ultrazohm/uz_a_iepe/Project Outputs for uz_d_iepe/BOM/BOM_uz_d_iepe_1v01.xls

Quantity | Comment | Designator | MF | MPN | Value | Description | Footprint | Package | Voltage | Dielectric | Supplier 1 | Supplier Part Number 1 | Supplier 2 | Supplier Part Number 2 | Supplier 3 | Supplier Part Number 3
39 | 0.1 µF | C1, C5A, C5B, C5C, C5D, C19, C21, C26, C28, C31, C33, C35, C42, C43, C45, C49, C51, C54, C56, C58, C65, C66, C69, C70, C72A, C72B, C72C, C72D, C73A, C73B, C73C, C73D, C77, C86, C88, C92, C93, C95, C103 |  |  | 0.1 µF | Capacitor 0603, 50 VDC, 0.1 µF, X7R, Capacitor 0603, 25 VDC, 0.1 µF, X7R | C_0603 |  |  |  | Mouser | 80-C0603X104K5R7411, 80-C0603C104J3RE7411 | LCSC, [NoParam] | #NAME?, [NoParam]
8 | 750 pF | C2A, C2B, C2C, C2D, C3A, C3B, C3C, C3D |  |  | 750 pF | Capacitor 0603, 50 VDC, 750 pF, C0G | C_0603 |  |  |  | Mouser | 80-C0603C751J5GAUTO
8 | 10 µF | C4A, C4B, C4C, C4D, C11A, C11B, C11C, C11D |  |  | 10 µF | Capacitor 0805, 25 VDC, 10 µF, X5R | C_0805 |  |  |  | Mouser | 81-GRM219R61E106KA2D
16 | 1 µF | C6A, C6B, C6C, C6D, C7A, C7B, C7C, C7D, C12A, C12B, C12C, C12D, C38A, C38B, C38C, C38D |  |  | 1 µF | Capacitor 0603, 6.3 VDC, 1 µF, X7R, Capacitor 0603, 50 VDC, 1 µF, X7R | C_0603 |  |  |  | Mouser | 963-JMK107BJ105MA-T, 963-UMK107AB7105KA-T
8 | 18 nF | C8A, C8B, C8C, C8D, C10A, C10B, C10C, C10D |  |  | 18 nF | Capacitor 0603, 16 VDC, 18 nF, X7R | C_0603 |  |  |  | Mouser | 80-C0603C183K4R
4 | 12 nF | C9A, C9B, C9C, C9D |  |  | 12 nF | Capacitor 0603, 16 VDC, 12 nF, X7R | C_0603 |  |  |  | Mouser | 603-CC603KRX7R7BB123
16 | 470nF | C13A, C13B, C13C, C13D, C14A, C14B, C14C, C14D, C15A, C15B, C15C, C15D, C16A, C16B, C16C, C16D |  |  |  | Capacitor 0603, 25 VDC, 0.1 µF, X7R | C_0603
30 | 10 µF | C17, C20, C22, C24, C27, C29, C30, C36, C39, C41, C46, C47, C48, C52, C53, C57, C59, C63, C64, C67, C68, C71, C74, C80, C81, C85, C89, C90, C94, C96 |  |  | 10 µF | Capacitor 1206, 50 VDC, 10 µF, X7R, Capacitor 1206, 25 VDC, 10 µF, X7R, Capacitor 1206, 35 VDC, 10 µF, X5R | C_1206 |  |  |  | Mouser | 810-CGA5L1X7R1H106K1, 80-C1206C106J3RAUTO, 581-1206DD106MAT2A
20 | 0.01 µF | C18, C23, C25, C34, C40, C44, C50, C55, C60, C61, C78, C83A, C83B, C83C, C83D, C84A, C84B, C84C, C84D, C97 |  |  | 0.01 µF | Capacitor 0603, 50 VDC, 0.01 µF, X7R | C_0603 |  |  |  | Mouser | 81-GCJ188R71H103KA1D
8 | 75 pF | C32A, C32B, C32C, C32D, C37A, C37B, C37C, C37D |  |  | 75 pF | Capacitor 0603, 50 VDC, 75 pF, X7R | C_0603 |  |  |  | Mouser | 80-C0603C750J5RAUTO
2 | 7.5 nF | C62, C79 |  |  | 7.5 nF | Capacitor 0603, 25 VDC, 7.5 nF, C0G | C_0603 |  |  |  | Mouser | 80-C0603C752J3GACTU
2 | 47 µF | C75, C91 |  |  | 47 µF | Capacitor, 47µF, 35VDC Al Electrolyt | CAPAE830X650N |  |  |  | Mouser | 667-EEE-1VA470P | LCSC | #NAME?
2 | 0.027 µF | C76, C87 |  |  | 0.027 µF | Capacitor 0603, 50 VDC, 27 nF, X7R | C_0603 |  |  |  | Mouser | 581-06035C273J4T2A
4 | 100nF | C82A, C82B, C82C, C82D |  |  |  | Capacitor 0603, 25 VDC, 0.1 µF, X7R | C_0603
10 | #NAME? | D1, D2, D3, D4, D5, D6, D10, D11, D12, D13 |  |  |  | WL-SMCW SMD Mono-color Chip LED Waterclear Green, WL-SMCW SMD Mono-color Chip LED Waterclear Red, WL-SMCW SMD Mono-color Chip LED Waterclear Blue | WL-SMCW_0603 |  |  |  | Mouser | 710-150060GS84000, 710-150060RS86000, 710-150060BS84000 | Farnell | 3408612, 3408608, 3408611 | Digi-Key | 732-150060GS84000CT-ND, 732-150060RS86000CT-ND, 732-150060BS84000CT-ND
2 | #NAME? | D7, D8 |  |  | - | Schottky Rectifier, 1.5 A, 90 V | DIOM4227X23N |  |  |  | Mouser | 625-BYS12-90-E3/TR3
4 | #NAME? | D9A, D9B, D9C, D9D |  |  |  | Current Regulator Diodes 100V 3.5mA | CRD |  |  |  | Mouser | 954-S-352T
4 | #NAME? | J1A, J1B, J1C, J1D |  |  |  | BNC Connector | Right Angle BNC |  |  |  | Digi-Key | A97560-ND
8 | #NAME? | L1A, L1B, L1C, L1D, L7, L9, L16, L17 |  |  | 600 Ohm | Inductance, 0805, 100 MHz, 600 Ohm, 2 A | WE-CBF_0805_High Current |  |  |  | Mouser | 710-742792040
12 | 600 Ohm | L2, L3, L4, L5, L6, L8, L10, L11, L12, L13, L18, L19 |  |  | 600 Ohm | Inductance, 0805, 100 MHz, 600 Ohm, 2 A | WE-CBF_0805_High Current |  |  |  | Mouser | 710-742792040
2 | 150 µH | L14, L15 | EPCOS / TDK | B82464G4154M | 150 µH | Inductor SMT, 10 x 10, 150 µH, 0.8 A | SMT_inductor_1050 |  |  |  | Mouser | 871-B82464G4154M
10 | 100R | R1, R2, R69A, R69B, R69C, R69D, R70A, R70B, R70C, R70D |  |  | 100R | SMD resistor E24 series | RES 0603_1608 |  |  |  | Mouser | 660-RK73B1JTTD101J
18 | 0R | R3, R4, R5, R6, R14A, R14B, R14C, R14D, R31, R32, R40A, R40B, R40C, R40D, R51A, R51B, R51C, R51D |  |  | 0R | SMD resistor E24 series | RES 0603_1608 |  |  |  | Mouser | 603-RC0603JR-070RL | LCSC | #NAME?
4 | 4.99R | R7, R8, R9, R10 |  |  | 4.99R | SMD resistor 1% | RES 0603_1608 |  |  |  | Mouser | 71-CRCW0603-4.99-E3
4 | 16k2 | R11A, R11B, R11C, R11D |  |  | 16k2 | SMD resistor 1% | RES 0603_1608 |  |  |  | Mouser | 603-AC0603FR-0716K2L
8 | 24R9 | R12A, R12B, R12C, R12D, R13A, R13B, R13C, R13D |  |  | 24R9 | SMD resistor 1% | RES 0603_1608 |  |  |  | Mouser | 603-RC0603FR-1324R9L
4 | 82k | R15A, R15B, R15C, R15D |  |  | 82k | SMD resistor E24 series | RES 0603_1608 |  |  |  | Mouser | 660-RK73B1JTTDD823J
4 | 39k | R16A, R16B, R16C, R16D |  |  | 39k | SMD resistor E24 series | RES 0603_1608 |  |  |  | Mouser | 660-RK73B1JTTDD393J
4 | 22k | R17A, R17B, R17C, R17D |  |  | 22k | SMD resistor E24 series | RES 0603_1608 |  |  |  | Mouser | 660-RK73B1JTTD223J
8 | 22R | R18A, R18B, R18C, R18D, R19A, R19B, R19C, R19D |  |  |  | SMD resistor E24 series | RES 0603_1608
2 | 162k | R20, R42 |  |  | 162k | SMD resistor 1% | RES 0603_1608 |  |  |  | Mouser | 652-CR0603-FX1623ELF
2 | 75k | R21, R43 |  |  | 75k | SMD resistor E24 series | RES 0603_1608 |  |  |  | Mouser | 660-RK73B1JTTD753J
32 | 10k | R22A, R22B, R22C, R22D, R24A, R24B, R24C, R24D, R38, R39, R50, R52A, R52B, R52C, R52D, R53, R54, R55A, R55B, R55C, R55D, R56, R57A, R57B, R57C, R57D, R58A, R58B, R58C, R58D, R61, R62 |  |  | 10k | SMD resistor E24 series, SMD resistor 1% | RES 0603_1608 |  |  |  | Mouser, Farnell | 660-RK73B1JTTD103J, 2447230
4 | 10R | R23A, R23B, R23C, R23D |  |  |  | SMD resistor E24 series | RES 0603_1608
2 | 1k62 | R25, R44 |  |  | 1k62 | SMD resistor 1% | RES 0603_1608 |  |  |  | Mouser | 667-ERJ-P03F1621V
2 | 133k | R26, R45 |  |  | 133k | SMD resistor 1% | RES 0603_1608 |  |  |  | Mouser | 652-CR0603FX-1333ELF
3 | 6k2 | R27, R28, R65 |  |  | 6k2 | SMD resistor E24 series | RES 0603_1608 |  |  |  | Mouser | 660-RK73B1JTTD622J
5 | 510R | R29, R30, R36, R37, R59 |  |  | 510R | SMD resistor E24 series | RES 0603_1608 |  |  |  | Mouser | 660-RK73B1JTTD511J
4 | 1k2 | R33A, R33B, R33C, R33D |  |  | 1k2 | SMD resistor E24 series | RES 0603_1608 |  |  |  | Mouser | 660-RK73B1JTTD122J
4 | 5k36 | R34A, R34B, R34C, R34D |  |  | 5k36 | SMD resistor 1% | RES 0603_1608 |  |  |  | Mouser | 603-AC0603FR-075K36L
4 | 174k | R35A, R35B, R35C, R35D |  |  | 174k | SMD resistor 1% | RES 0603_1608 |  |  |  | Mouser | 603-RC0603FR-07174KL
2 | 1k02 | R41, R46 |  |  | 1k02 | SMD resistor 1% | RES 0603_1608 |  |  |  | Mouser | 652-CR0603FX-1021ELF
2 | 93k1 | R47, R49 |  |  | 93k1 | SMD resistor 1% | RES 0603_1608 |  |  |  | Mouser | 667-ERJ-P03F9312V
1 | 10k2 | R48 |  |  | 10k2 | SMD resistor 1% | RES 0603_1608 |  |  |  | Mouser | 667-ERJ-3EKF1022V
1 | 32k4 | R60 |  |  | 32k4 | SMD resistor 1% | RES 0603_1608 |  |  |  | Mouser | 667-ERJ-3EKF3242V
1 | 27k | R63 |  |  | 27k | SMD resistor E24 series | RES 0603_1608 |  |  |  | Mouser | 660-RK73B1JTTD273J
1 | 1k | R66 |  |  | 1k | SMD resistor E24 series | RES 0603_1608 |  |  |  | Mouser | 660-RK73B1JTTDD102J
5 | #NAME? | SW1, SW2A, SW2B, SW2C, SW2D |  |  |  | 04p, 1.27mm Pitch, Horizontal, HP Type, SMT, flat Actuator, black, with Tape, T&R | 416131160804 |  |  |  | LCSC | C319050
27 | #NAME? | TP1, TP2, TP3, TP4, TP5, TP6, TP7, TP8, TP9, TP13A, TP13B, TP13C, TP13D, TP14A, TP14B, TP14C, TP14D, TP16, TP17, TP21, TP22, TP25, TP27, TP30, TP31, TP32, TP33 |  |  | TP | Test Point 1 mm | TP_1mm |  |  |  | - | -
1 | #NAME? | U1 |  |  | 1:04:00 | High Performance Clock Puffer, 1:4 LVCMOS Fan-out | FP-PW0008A-MFG |  |  |  | Mouser | 595-CDCLVC1104PWR
3 | #NAME? | U2, U3, U15 | Texas Instruments | TPS7A3001DGN | -1.18 V - -33 V | -35 V, -200 mA, ultralow-noise, negative linear regulator | DGN0008D_N |  |  |  | Mouser | 595-TPS7A3001DGNR | Mouser | 595-TPS7A3001DGNT |  | 3122632
3 | #NAME? | U3, U5, U7 | Texas Instruments | LP2985A-25 | 5 V, 3.3 V, 2.5 V | 150 mA Low-noise Low-dropout regulator with shutdown; fixed 5 V output, 150 mA Low-noise Low-dropout regulator with shutdown; fixed 3.3 V output, 150 mA Low-noise Low-dropout regulator with shutdown; fixed 2.5 V output | SOT95P250X110-5N | SOT-23-5 |  |  | Mouser | 595-LP2985A-50DBVT, 595-LP2985A-33DBVT, 595-LP2985A-25DBVT
4 | #NAME? | U4A, U4B, U4C, U4D |  |  | Differential ADC | Differential Input ADC with Wide Input Common Mode Range | TSSOP50P510X110_HS-17N |  |  |  | Mouser | 584-C2311CMSE-16PBF
1 | #NAME? | U8 |  |  |  | Low-Voltage 16-Bit I2C and SMBus Low-Power I/O Expander | SOP65P640X120-24N |  |  |  | Mouser | 595-TCA9535PWR
2 | #NAME? | U9, U11 |  |  | 500 mA | Buck Converter with 80 V integrated Power MOSFET, U_in 9 V - 75 V, U_out 2.5 V - 73 V, I_out 500 mA | TSOP65P490X110-8N |  |  |  | Mouser | 926-LM5007MM/NOPB
1 | #NAME? | U10 |  |  |  | 150 mA Low-noise Low-dropout regulator with shutdown | SOT95P250X110-5N | SOT-23-5 |  |  | Mouser | 595-LP2985A-18DBVJ
1 | #NAME? | U12 |  |  | 5 V | Precision Wide Supply High Output Drive Low Noise Reference, 5 V | SOT95P280X100-6N |  |  |  | Mouser | 584-6654AIS65TRMPBF
4 | #NAME? | U13A, U13B, U13C, U13D |  |  |  | Precision,Zero-Drift,High-Voltage,Programmable Gain Instrumentation Amplifier | PW0016A_N |  |  |  | Mouser | 595-PGA281AIPW
4 | #NAME? | U14A, U14B, U14C, U14D |  |  | Rail-to-Rail | Operational Amplifier, Rail-to-Rail, ultralow noise | MSOP8_3x3-8N |  |  |  | Mouser | 584-LT6203CMS8#PBF
