ultrazohm/uz_a_iepe/Project Outputs for uz_d_iepe/SCH_uz_d_iepe_1v01.PDF

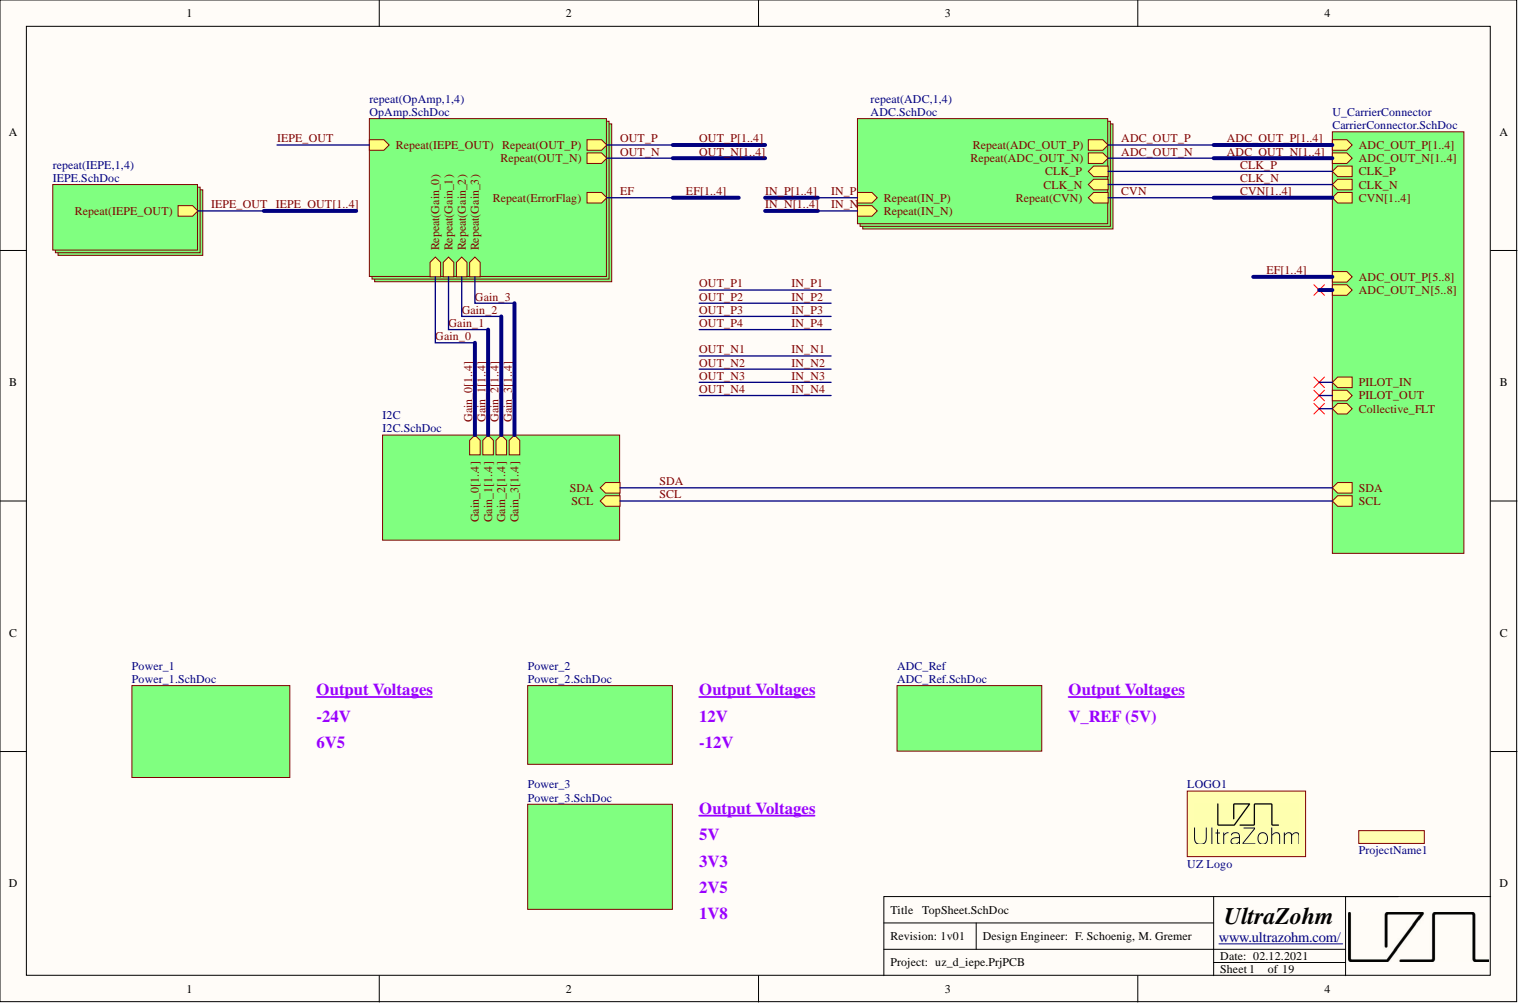
[picture p1: page 1]

Title TopSheet.SchDoc | www.ultrazohm.com/

Revision:
Project: uz_d_iepe.PrjPCB | Date: 02.12.2021

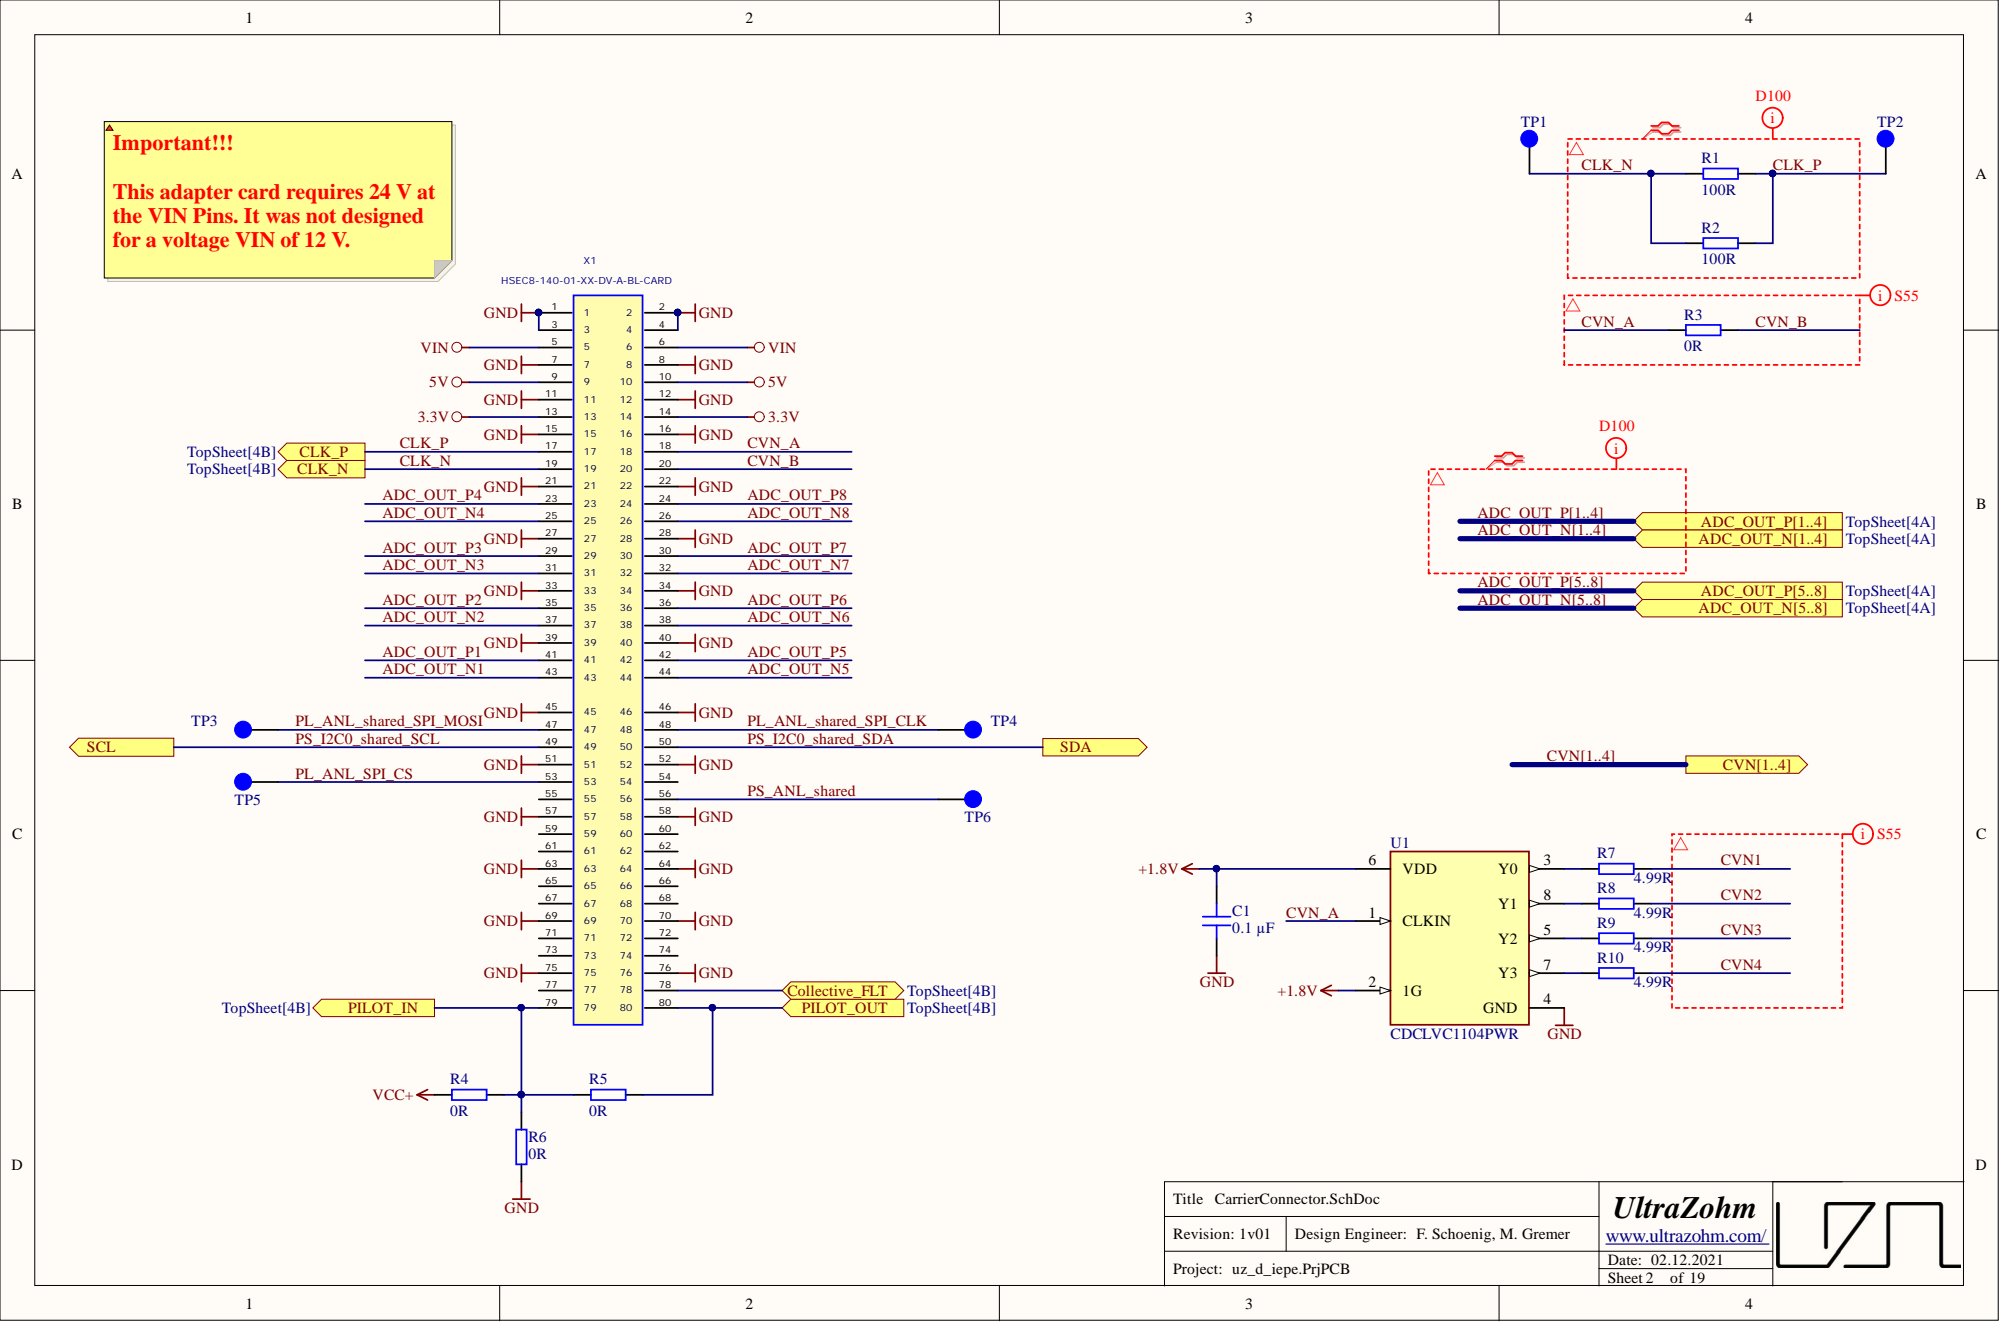
[picture p2: page 2]

This adapter card requires 24 V at
the VIN Pins. It was not designed
for a voltage VIN of 12 V.

HSEC8-140-01-XX-DV-A-BL-CARD

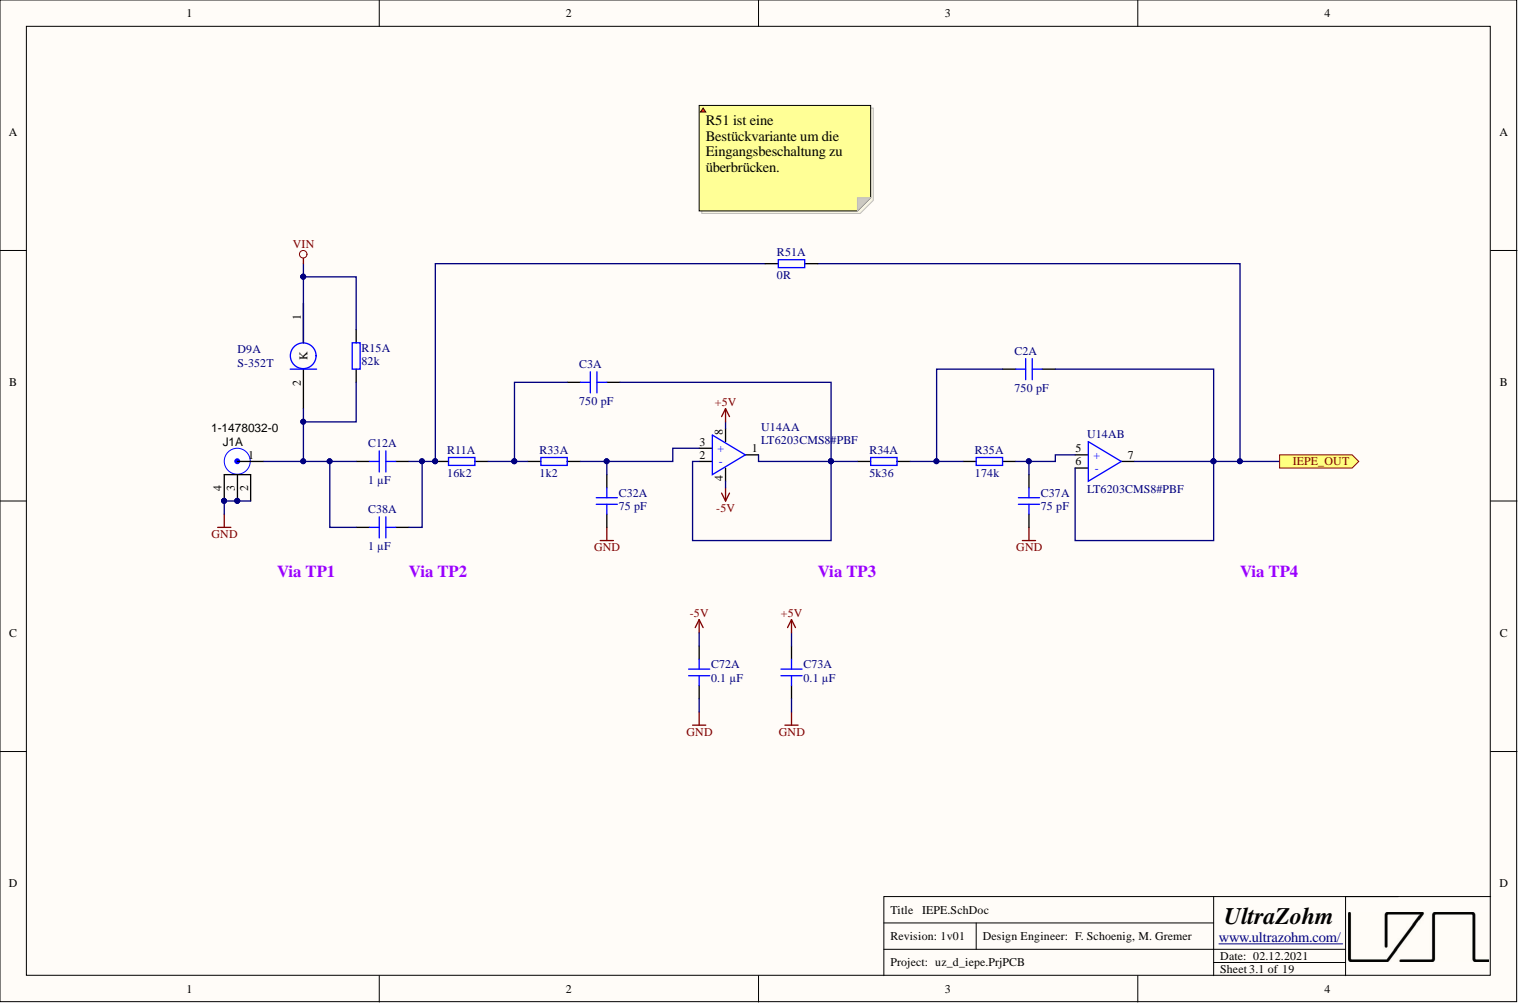
[picture p3: page 3]

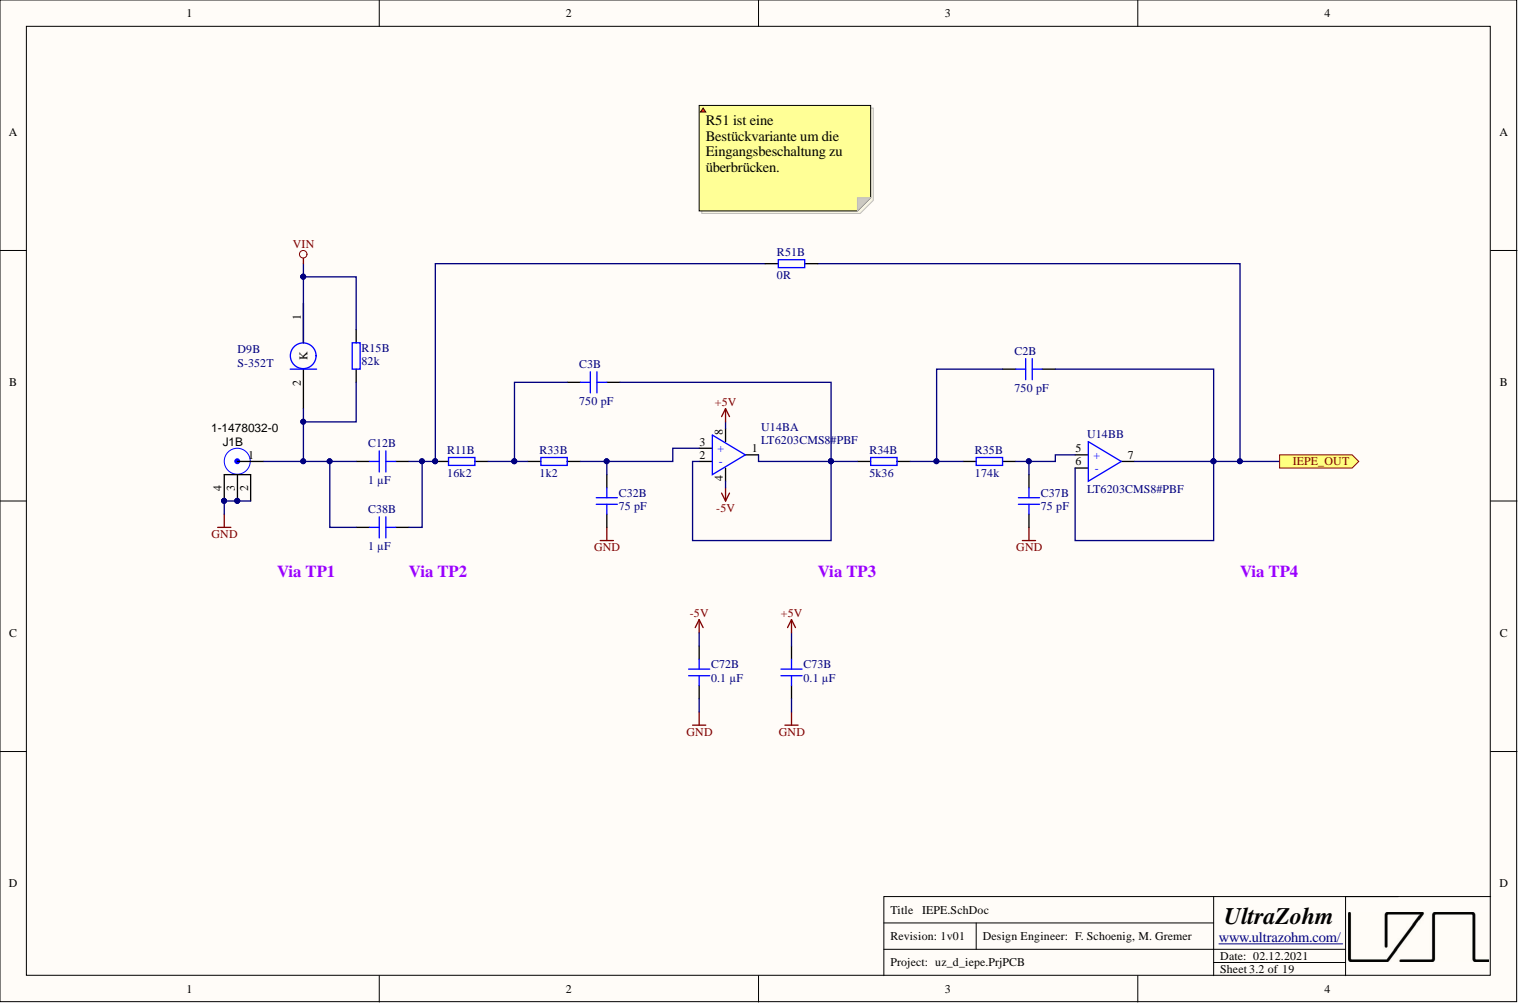
[picture p4: page 4]

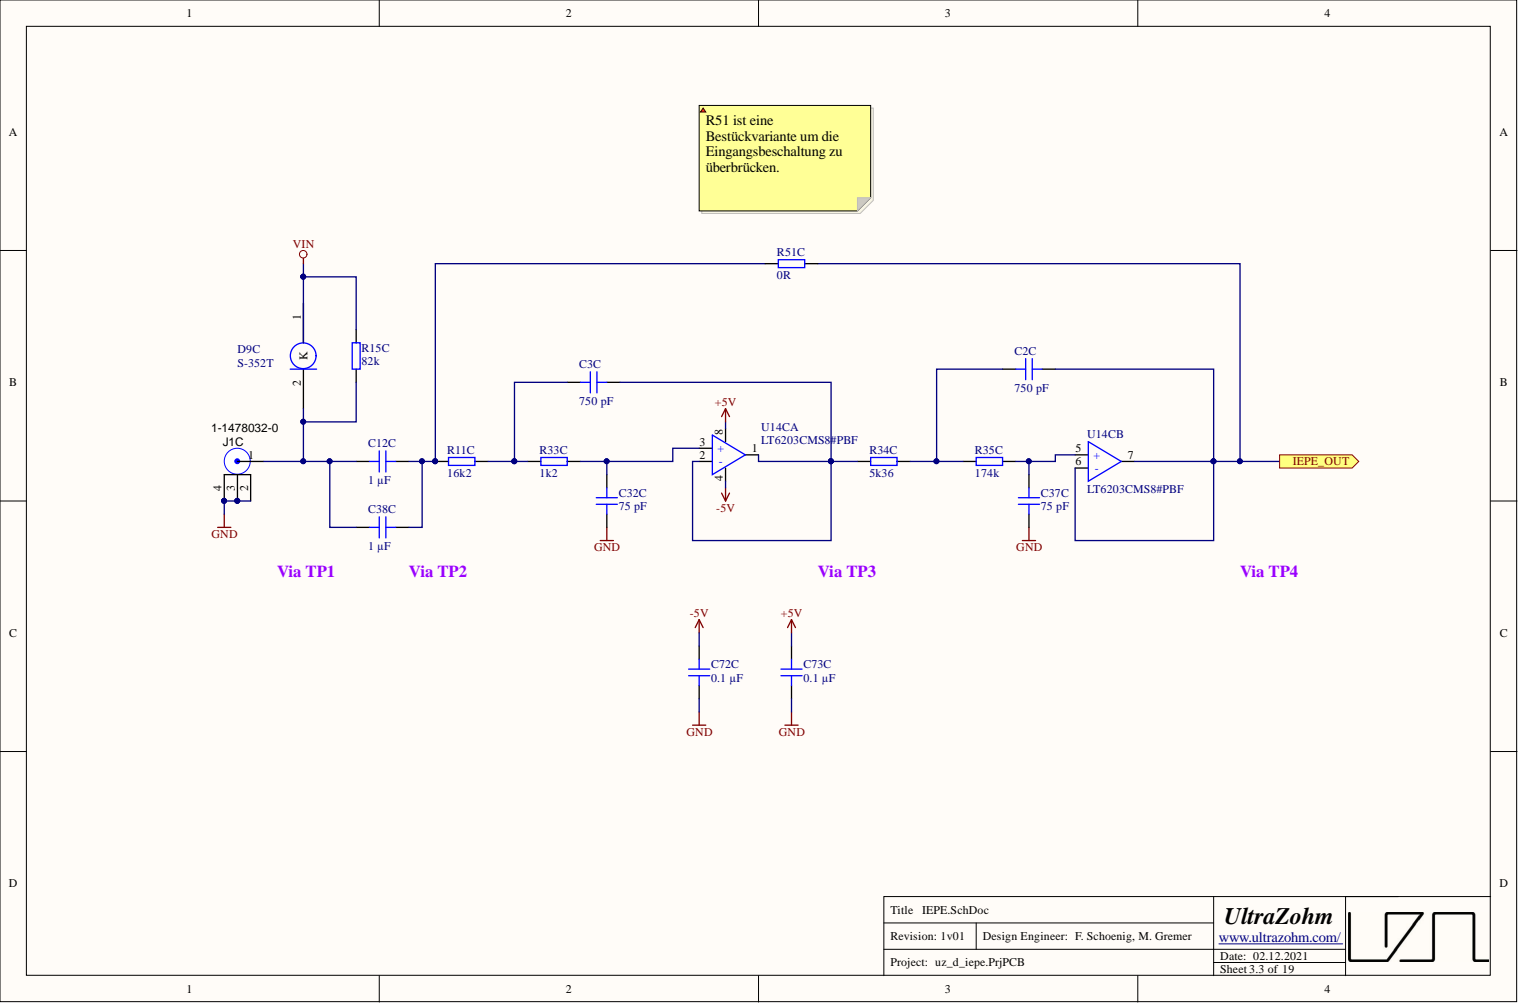
[picture p5: page 5]

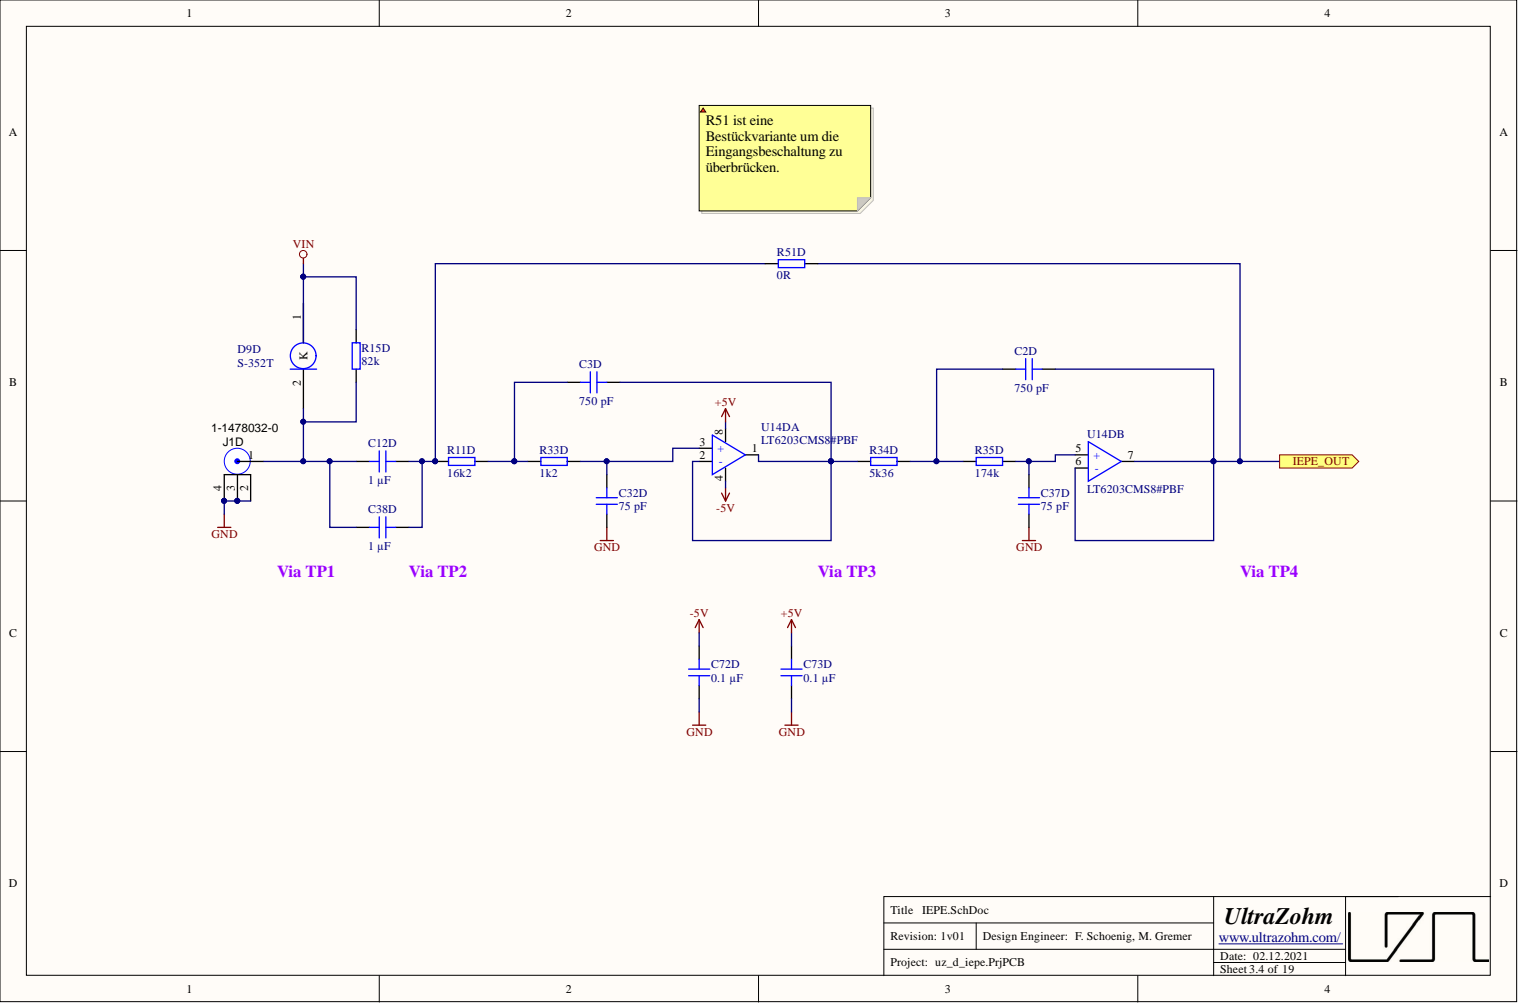
[picture p6: page 6]

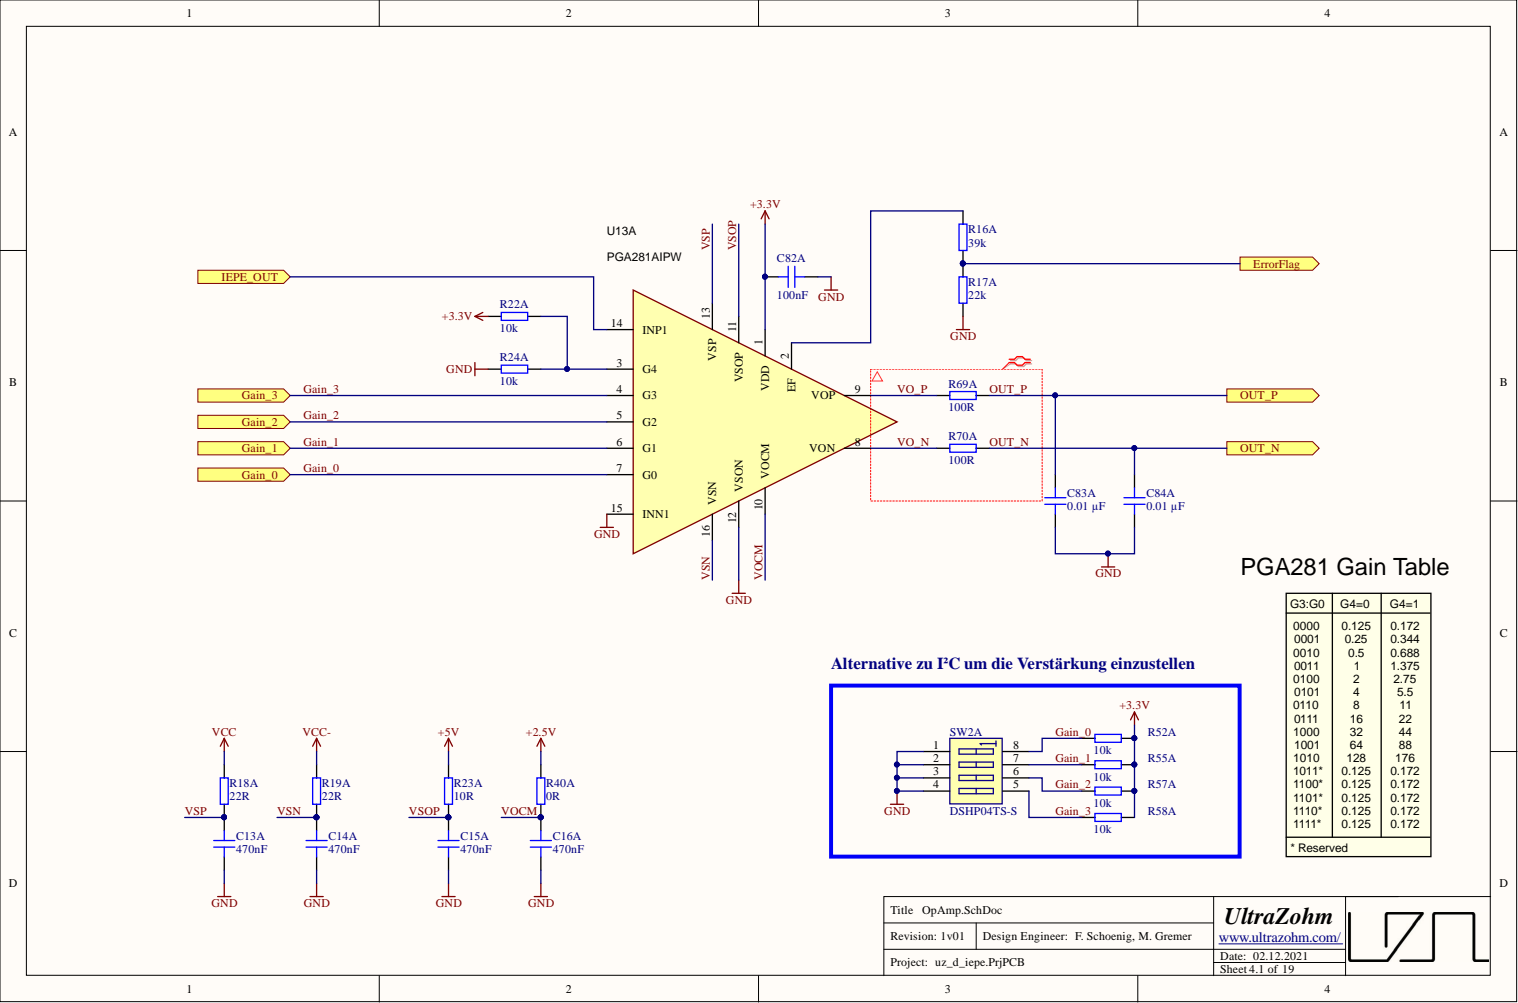
[picture p7: page 7]

Alternative zu I²C um die Verstärkung einzustellen

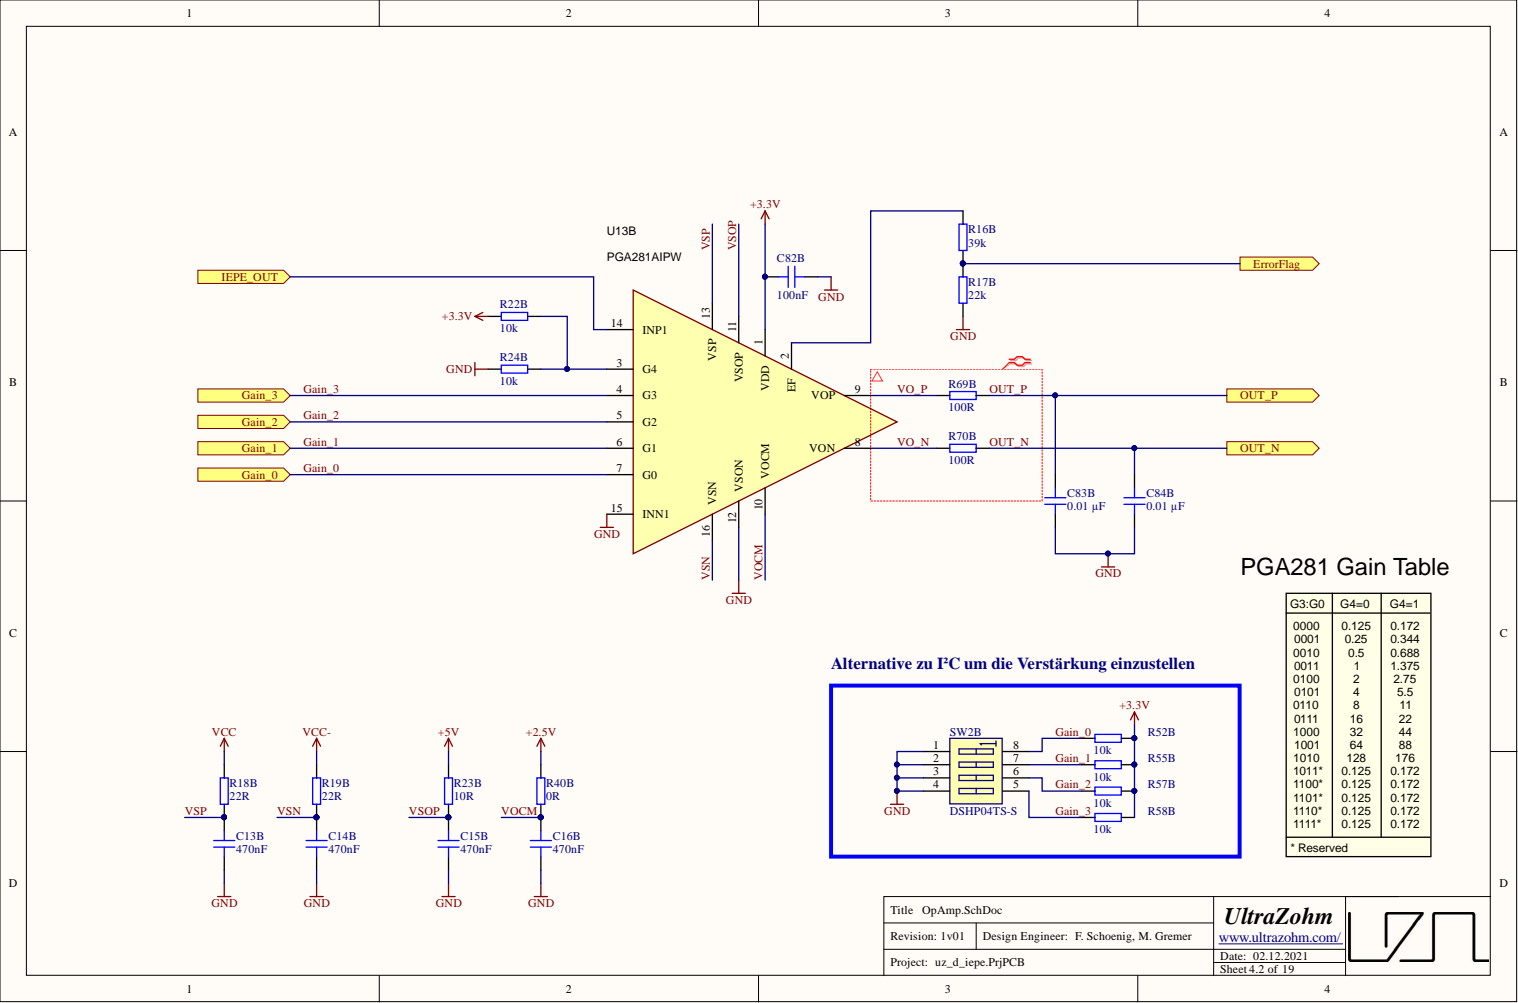
[picture p8: page 8]

Alternative zu I²C um die Verstärkung einzustellen

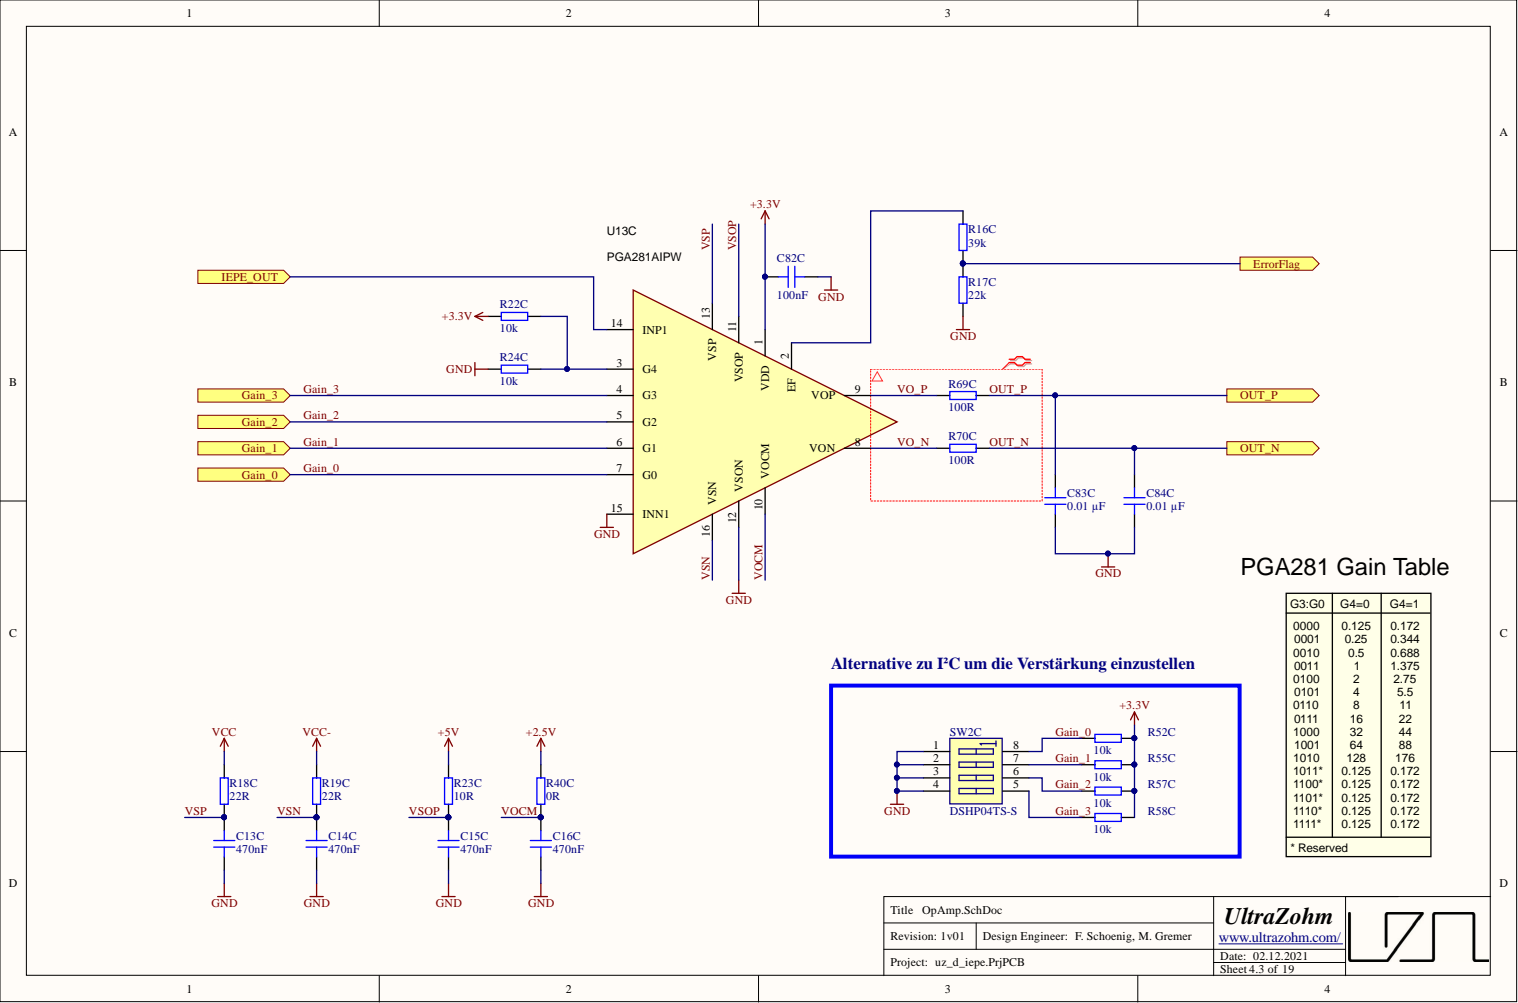
[picture p9: page 9]

Alternative zu I²C um die Verstärkung einzustellen

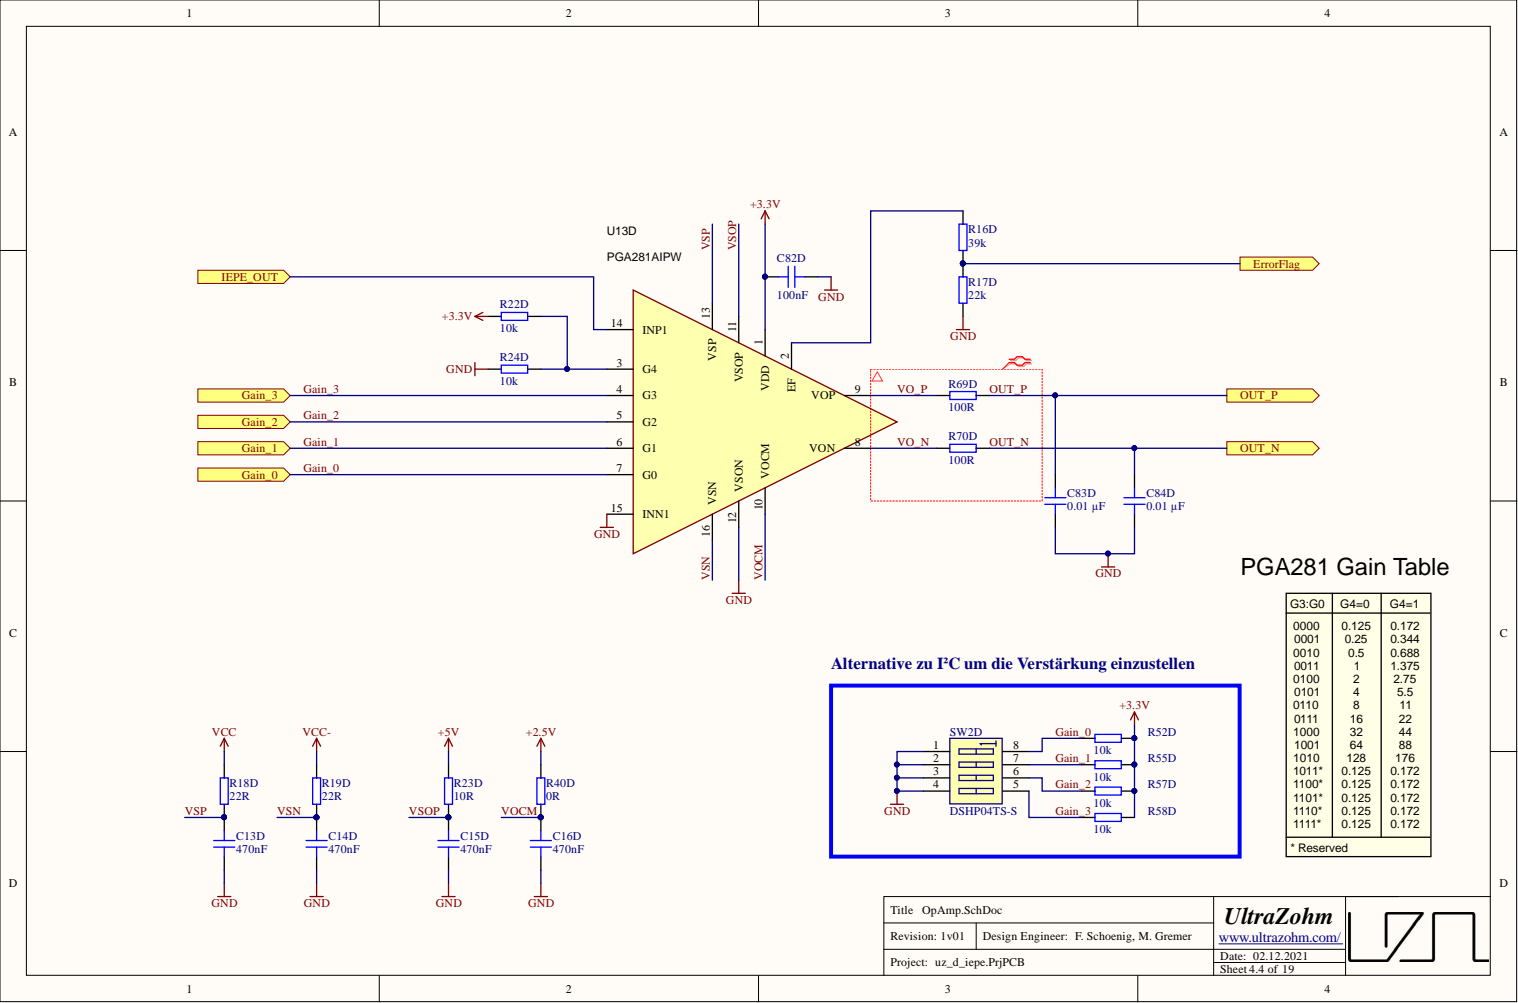
[picture p10: page 10]

Alternative zu I²C um die Verstärkung einzustellen

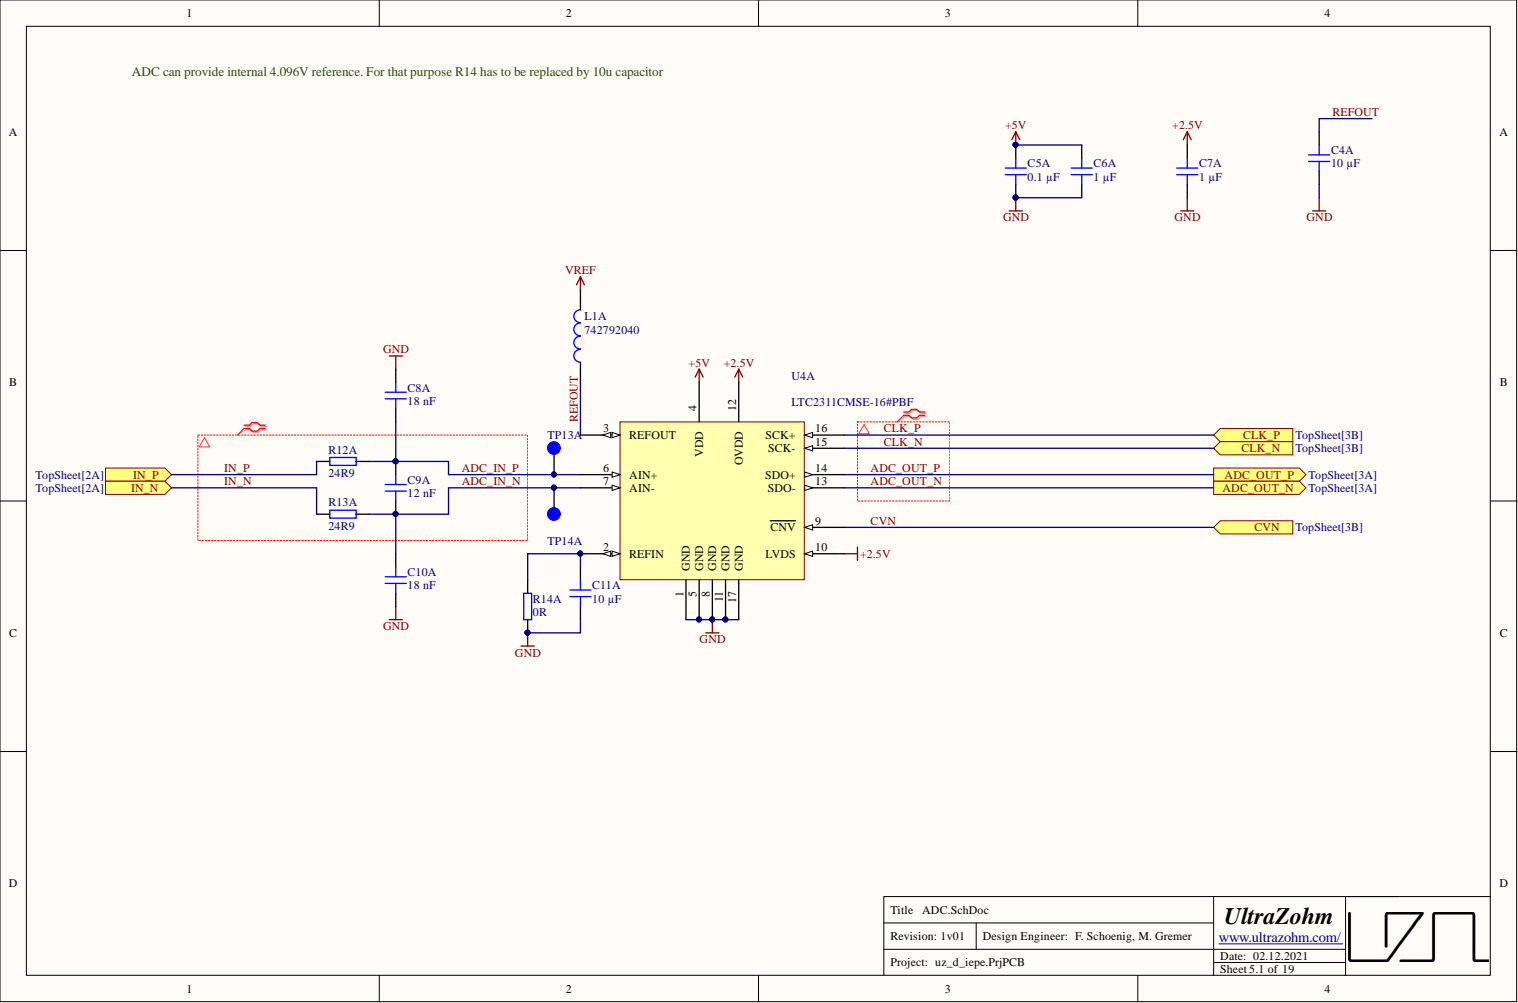
[picture p11: page 11]

IN _ P
IN _ N | A DC_IN _ N | 7 | 1 | A DC_ O U T _ N

14 3 SDO+ | A DC_ O U T _ P

T i t l e A DC.Sch D o c | UltraZohm w w.ultra z o h m.c m/

Rev i s n : v | Des g n E neer: F. Sch oen g, M. Gremer

Project uz_ d _ iepe.PrjPCB

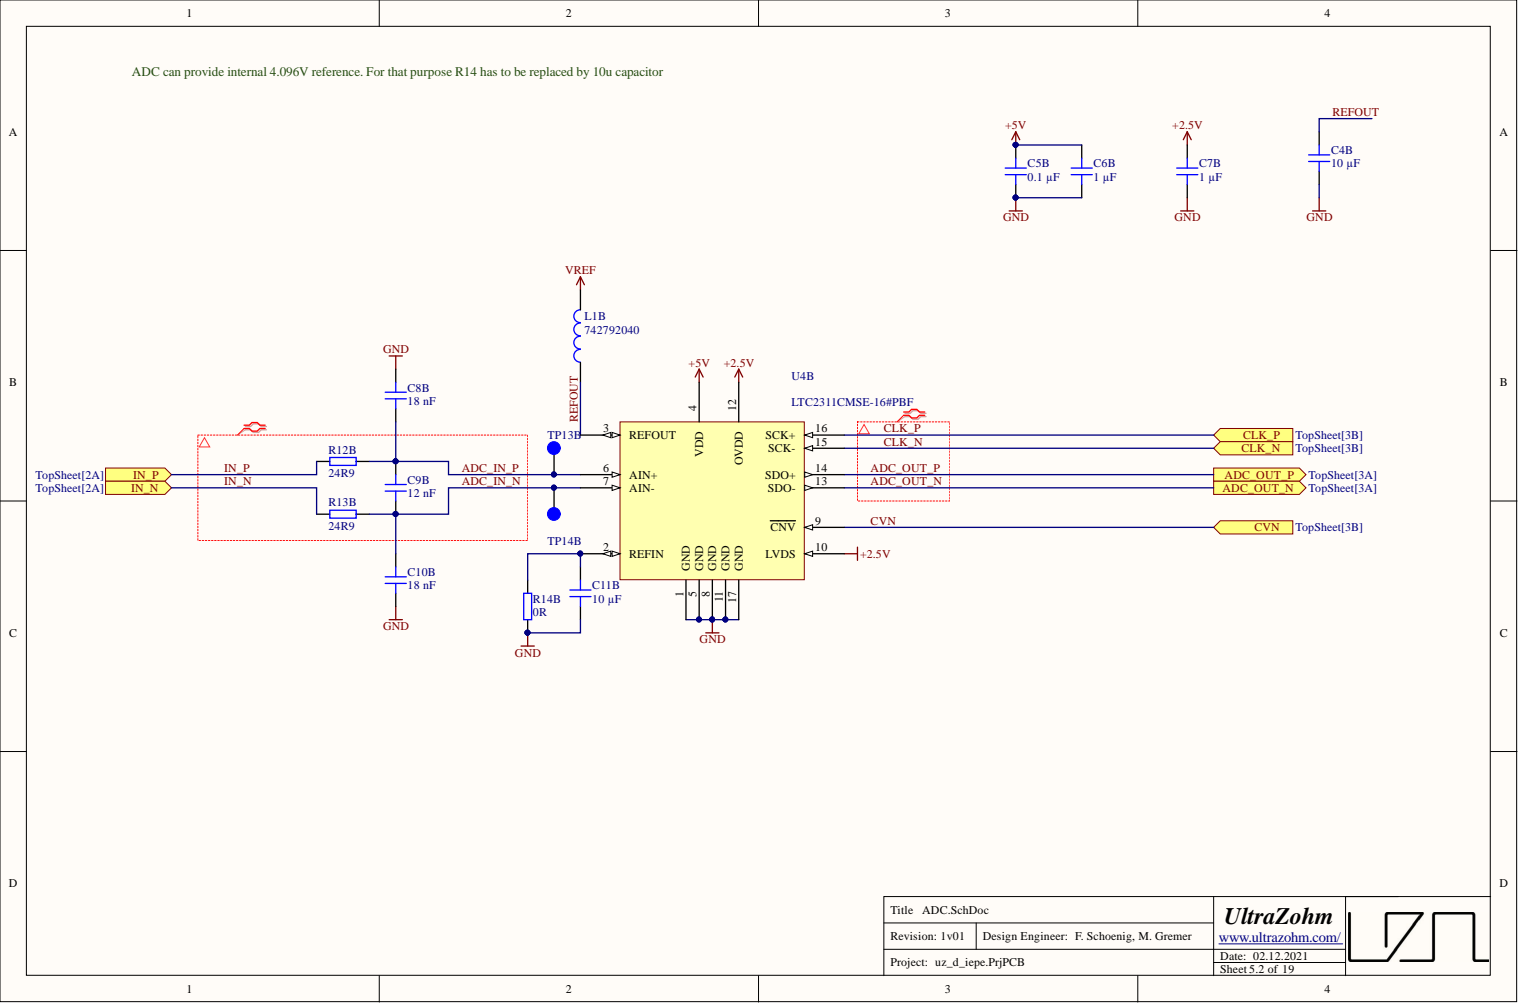
[picture p12: page 12]
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

14 3 SDO+ | A DC_ O U T _ P

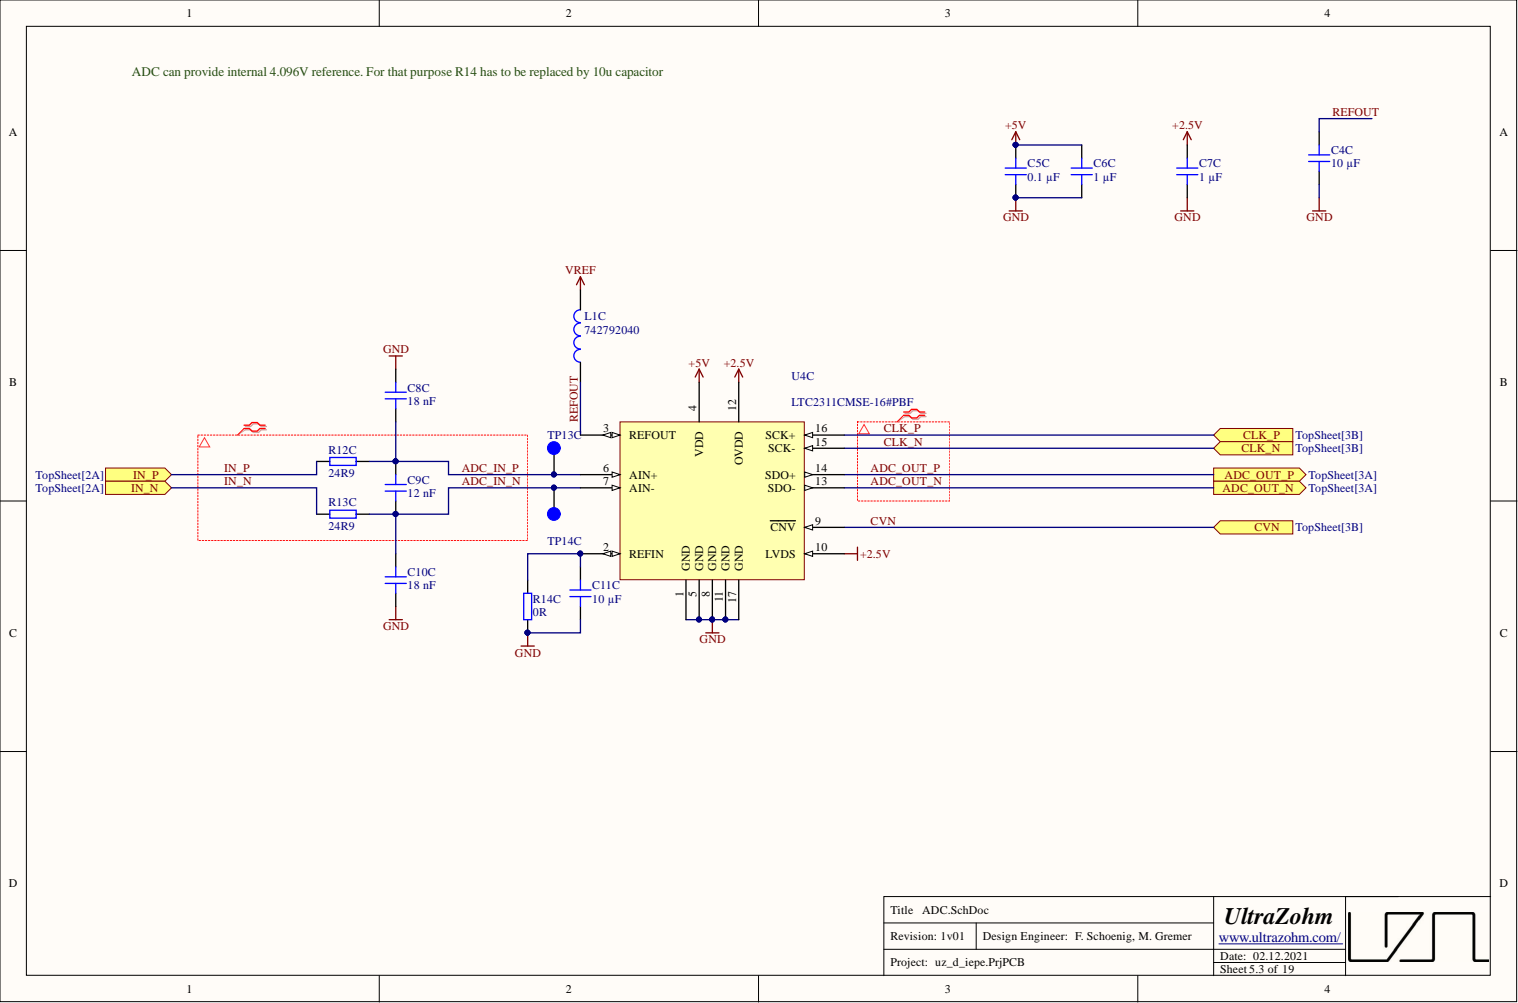
[picture p13: page 13]
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

14 3 SDO+ | A DC_ O U T _ P

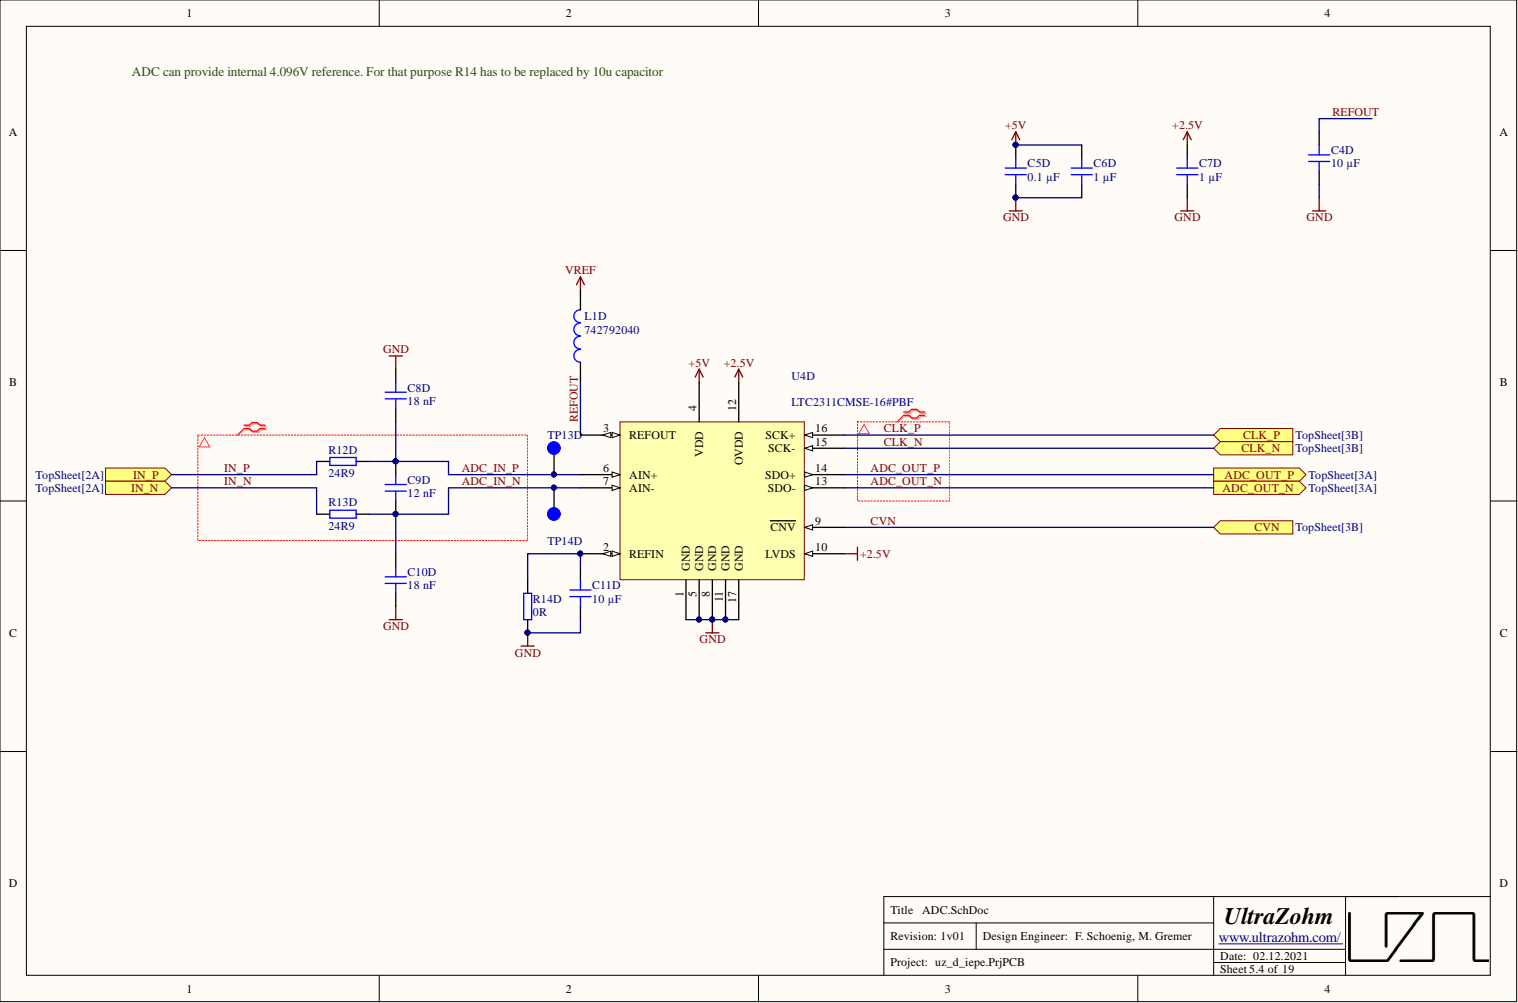
[picture p14: page 14]
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

14 3 SDO+ | A DC_ O U T _ P

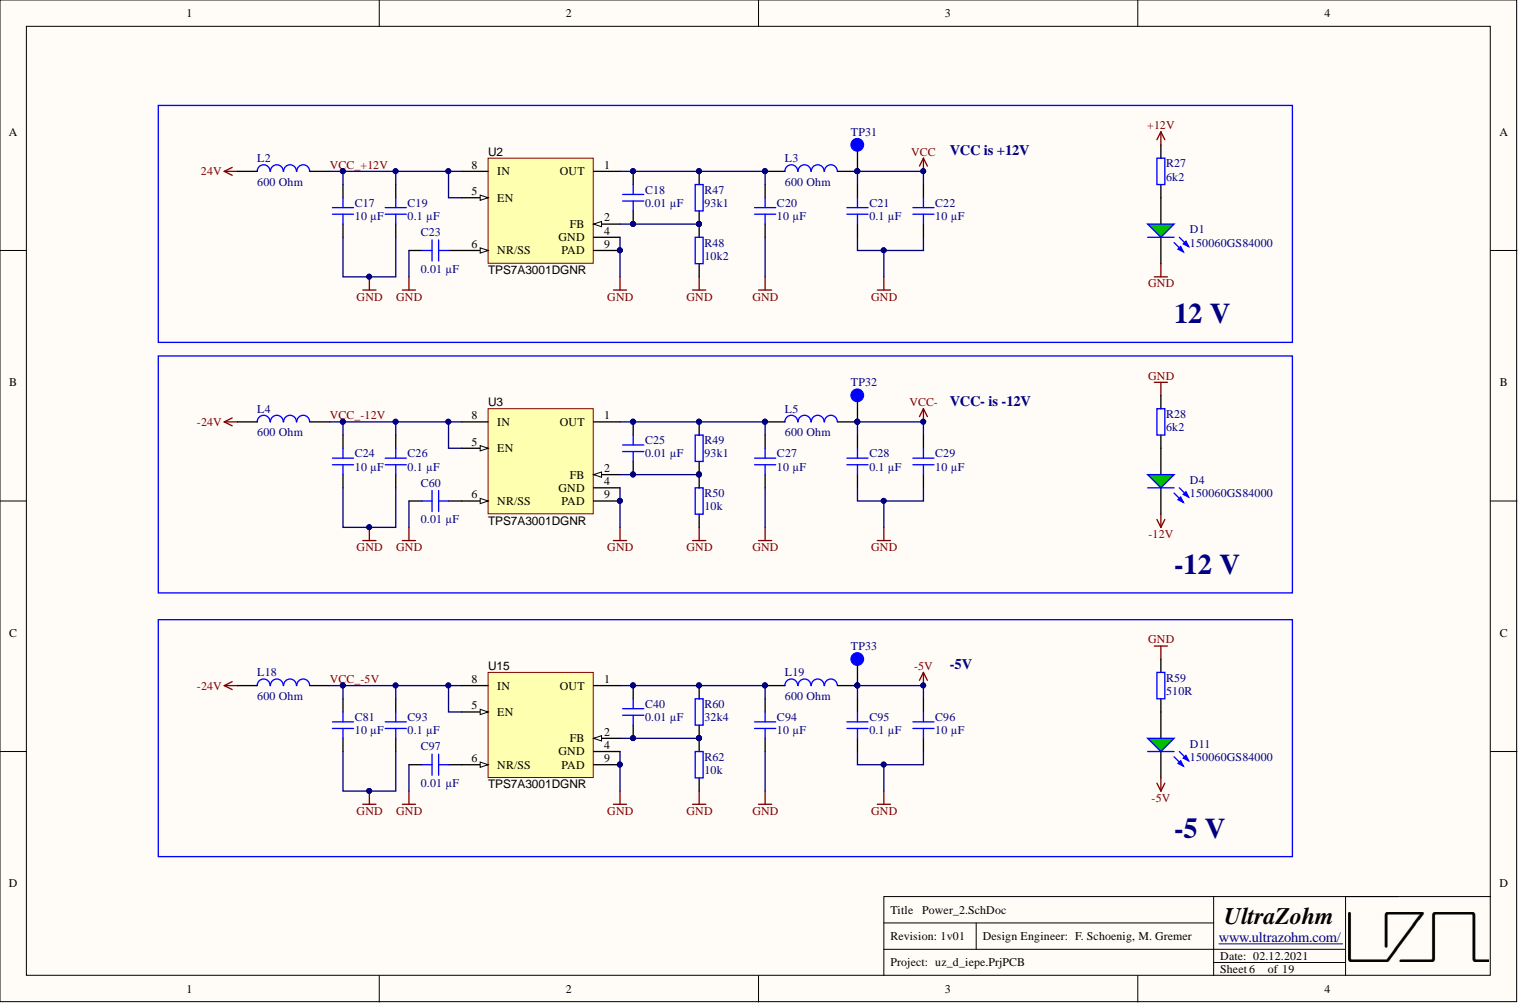
[picture p15: page 15]

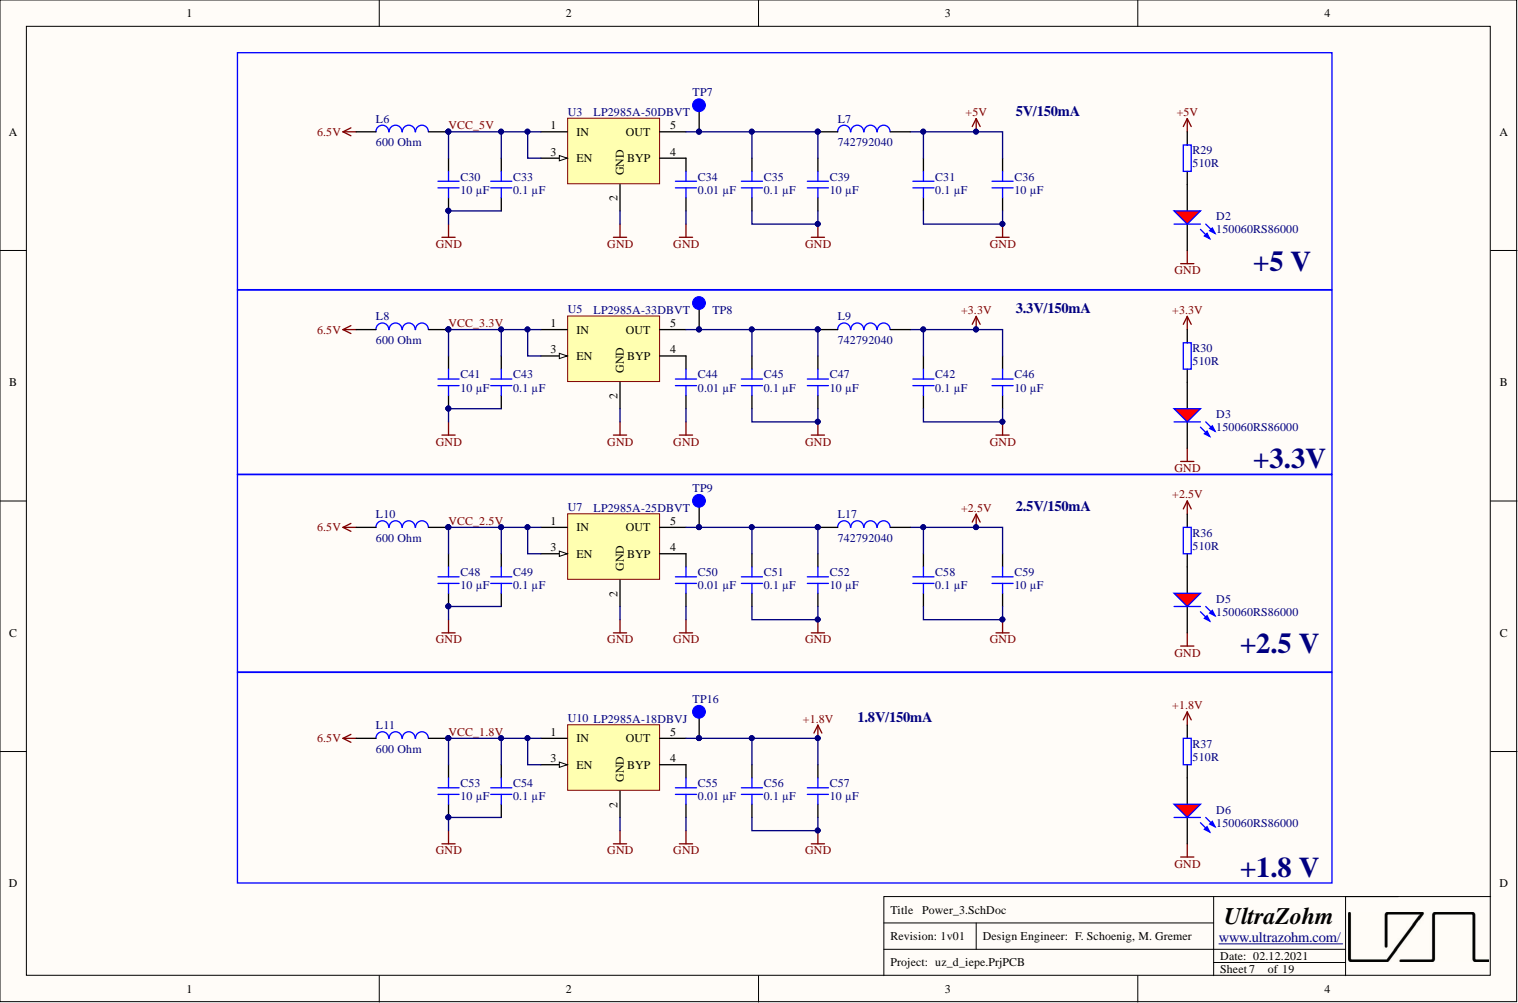
[picture p16: page 16]

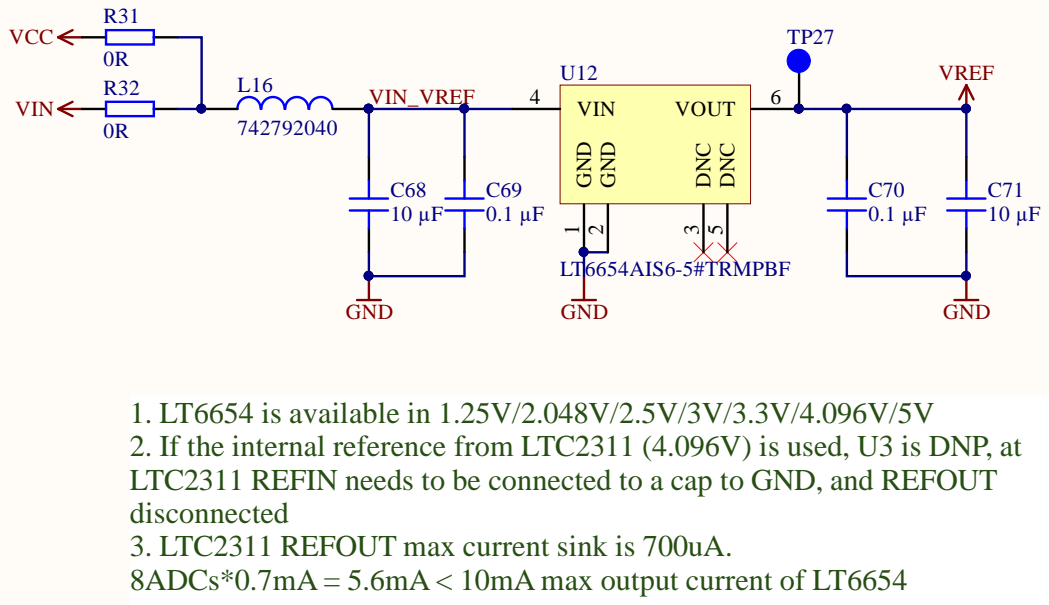
[picture p17: page 17]

1. LT6654 is available in 1.25V/2.048V/2.5V/3V/3.3V/4.096V/5V
2. If the internal reference from LTC2311 (4.096V) is used, U3 is DNP, at
LTC2311 REFIN needs to be connected to a cap to GND, and REFOUT
disconnected
3. LTC2311 REFOUT max current sink is 700uA.
8ADCs*0.7mA = 5.6mA < 10mA max output current of LT6654

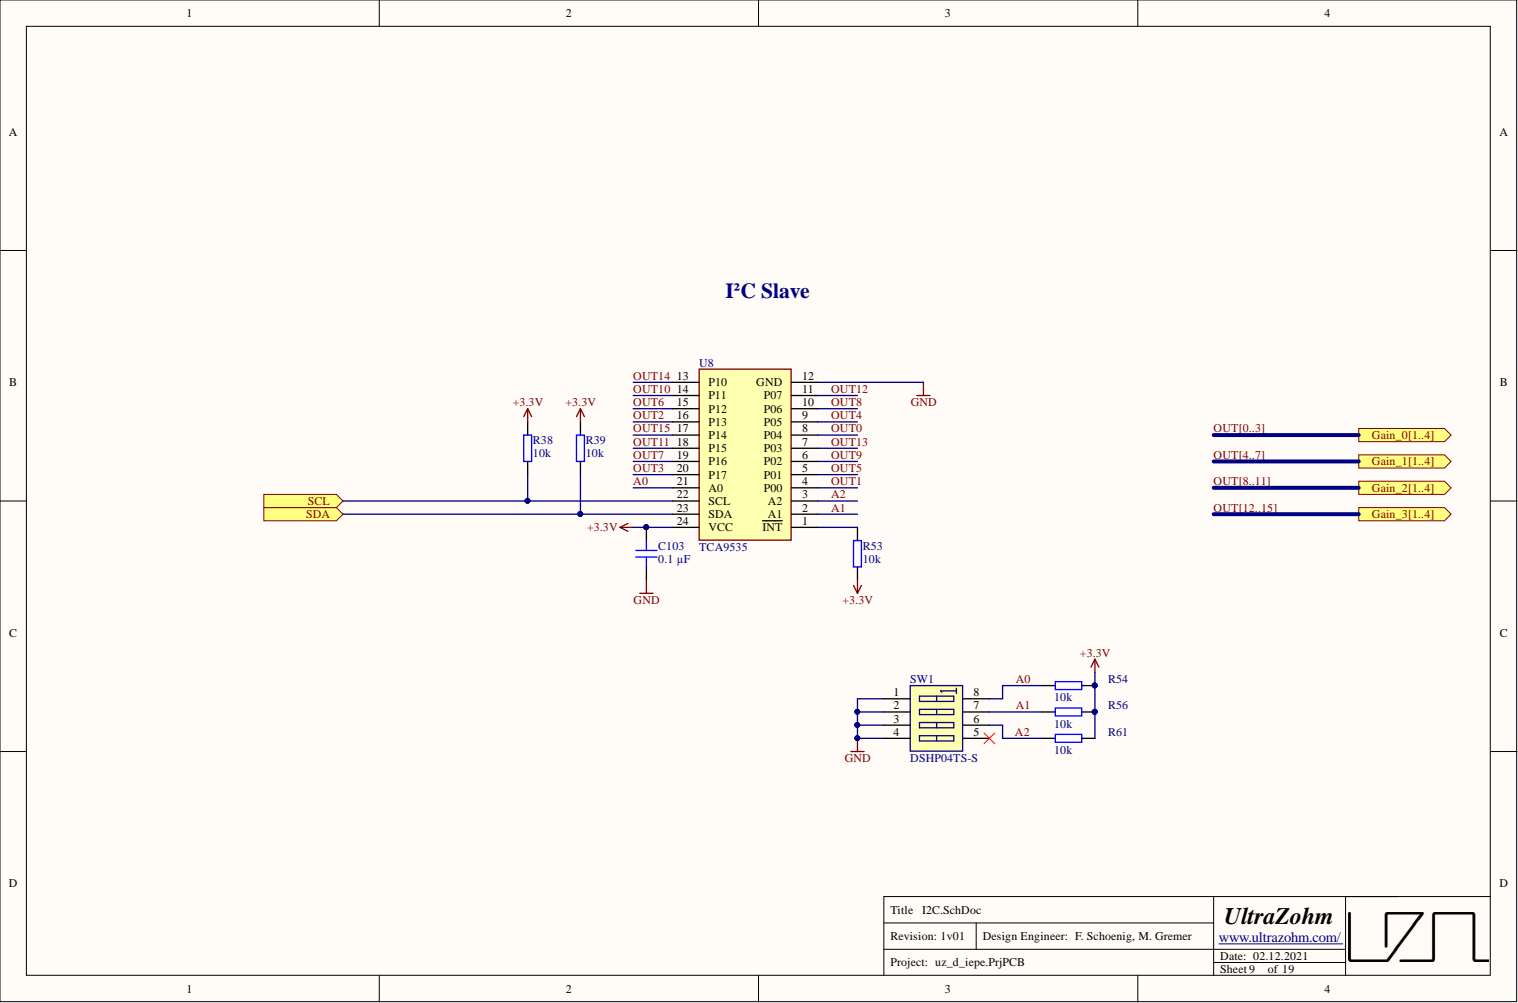
[picture p18: page 18]

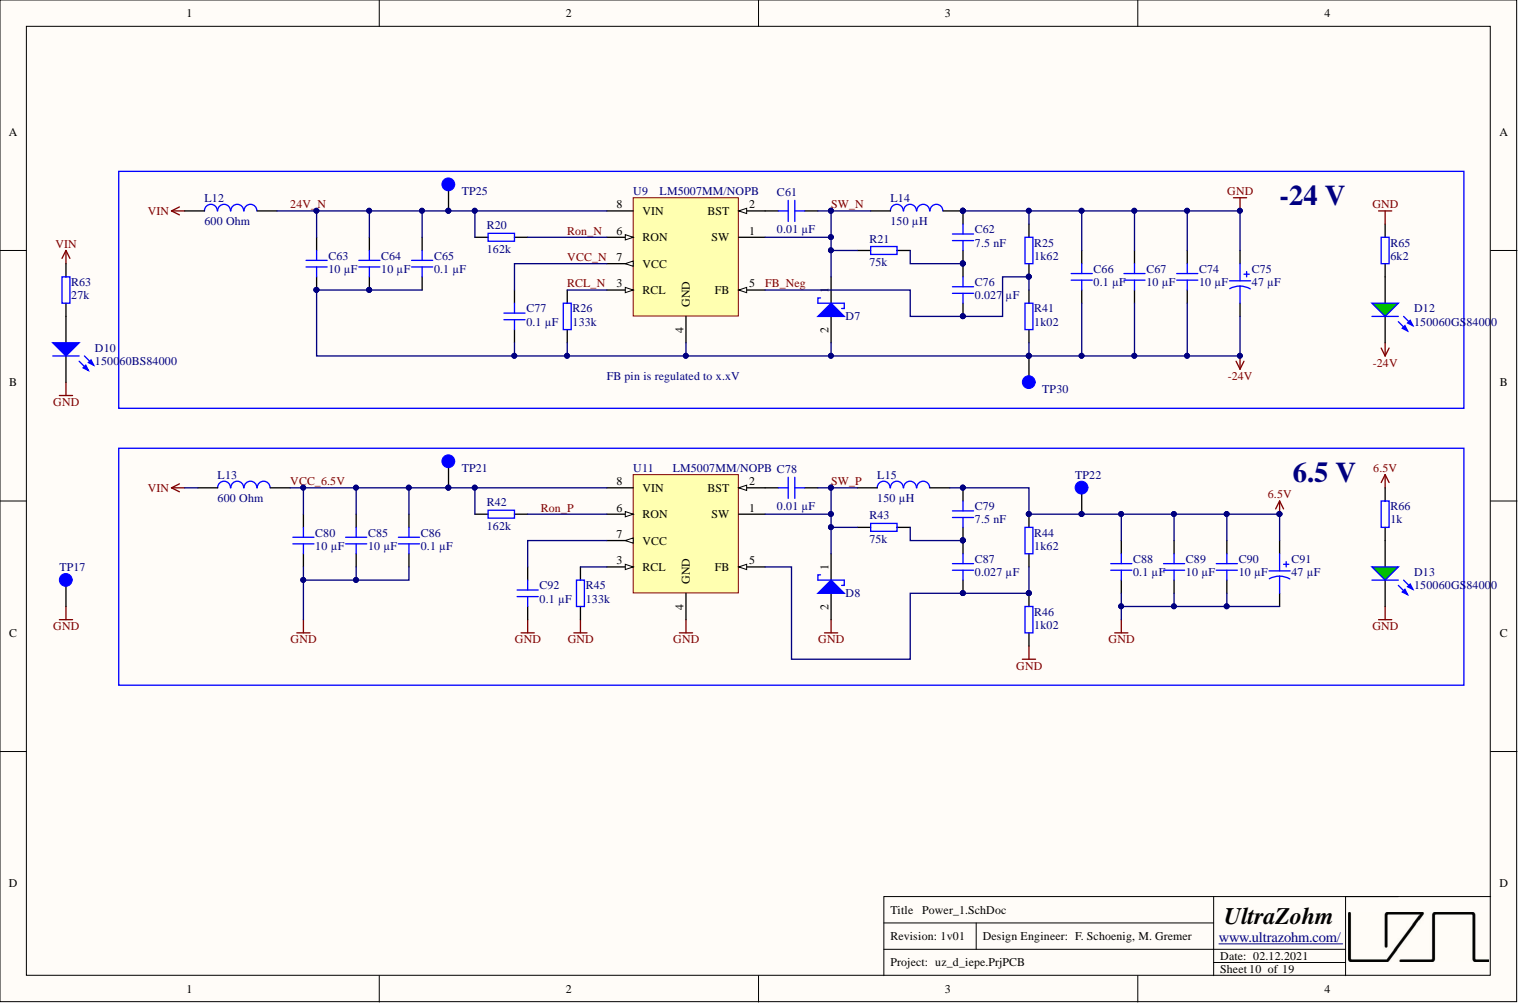
[picture p19: page 19]
