ultrazohm/uz_a_iepe/Project Outputs for uz_d_iepe/3D_View_Top.PDF

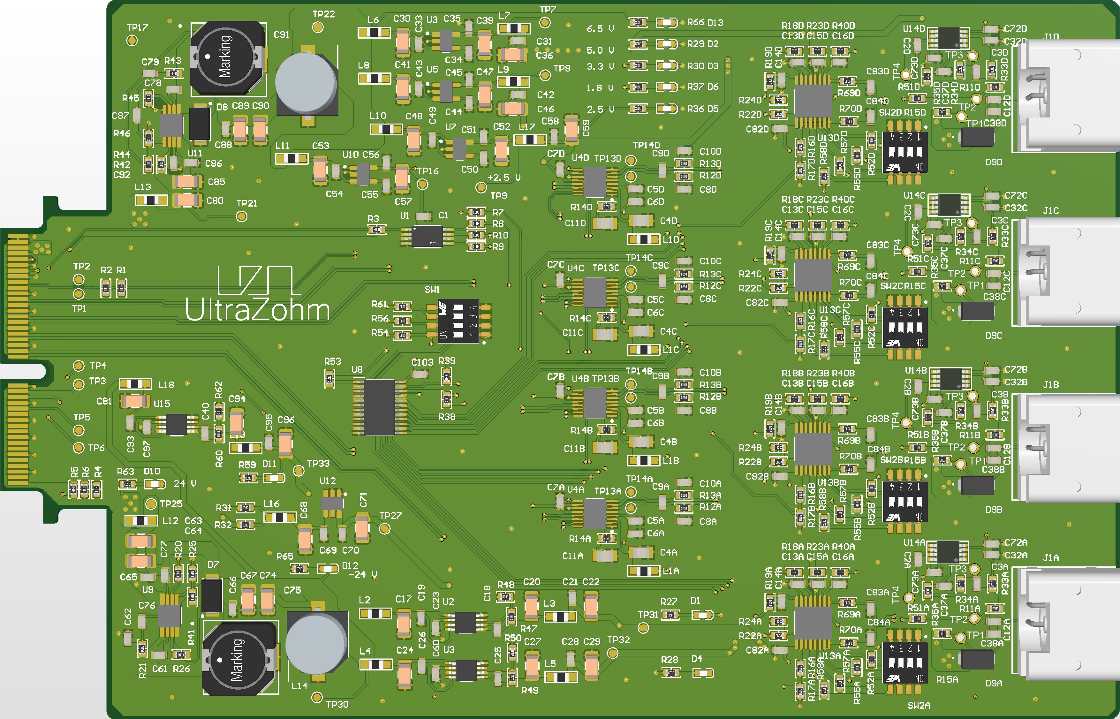
[picture p20: page 1]
