ultrazohm/uz_a_iepe/Project Outputs for uz_d_iepe/ASM_uz_d_iepe_1v01.PDF

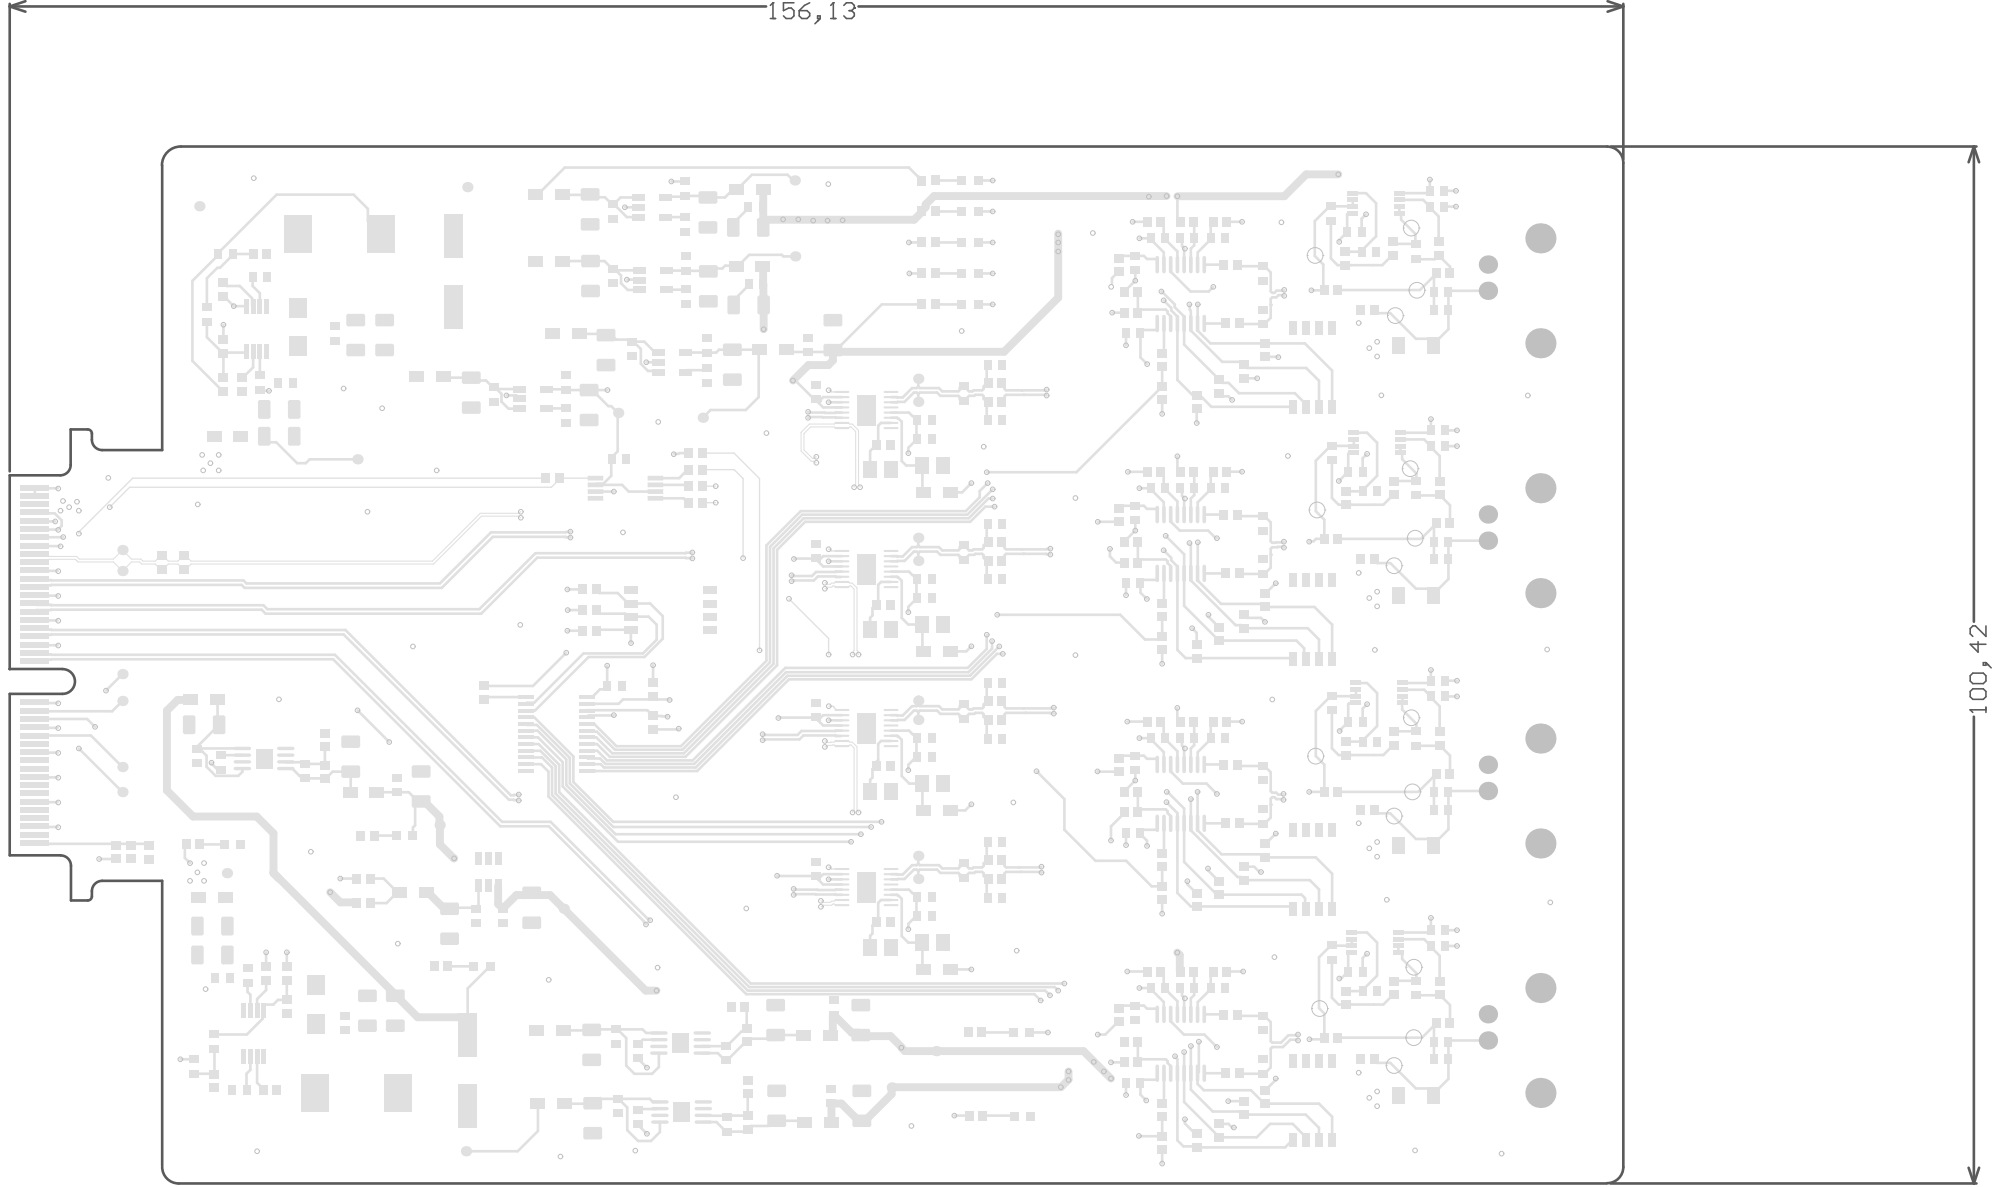
[picture p21: page 1]

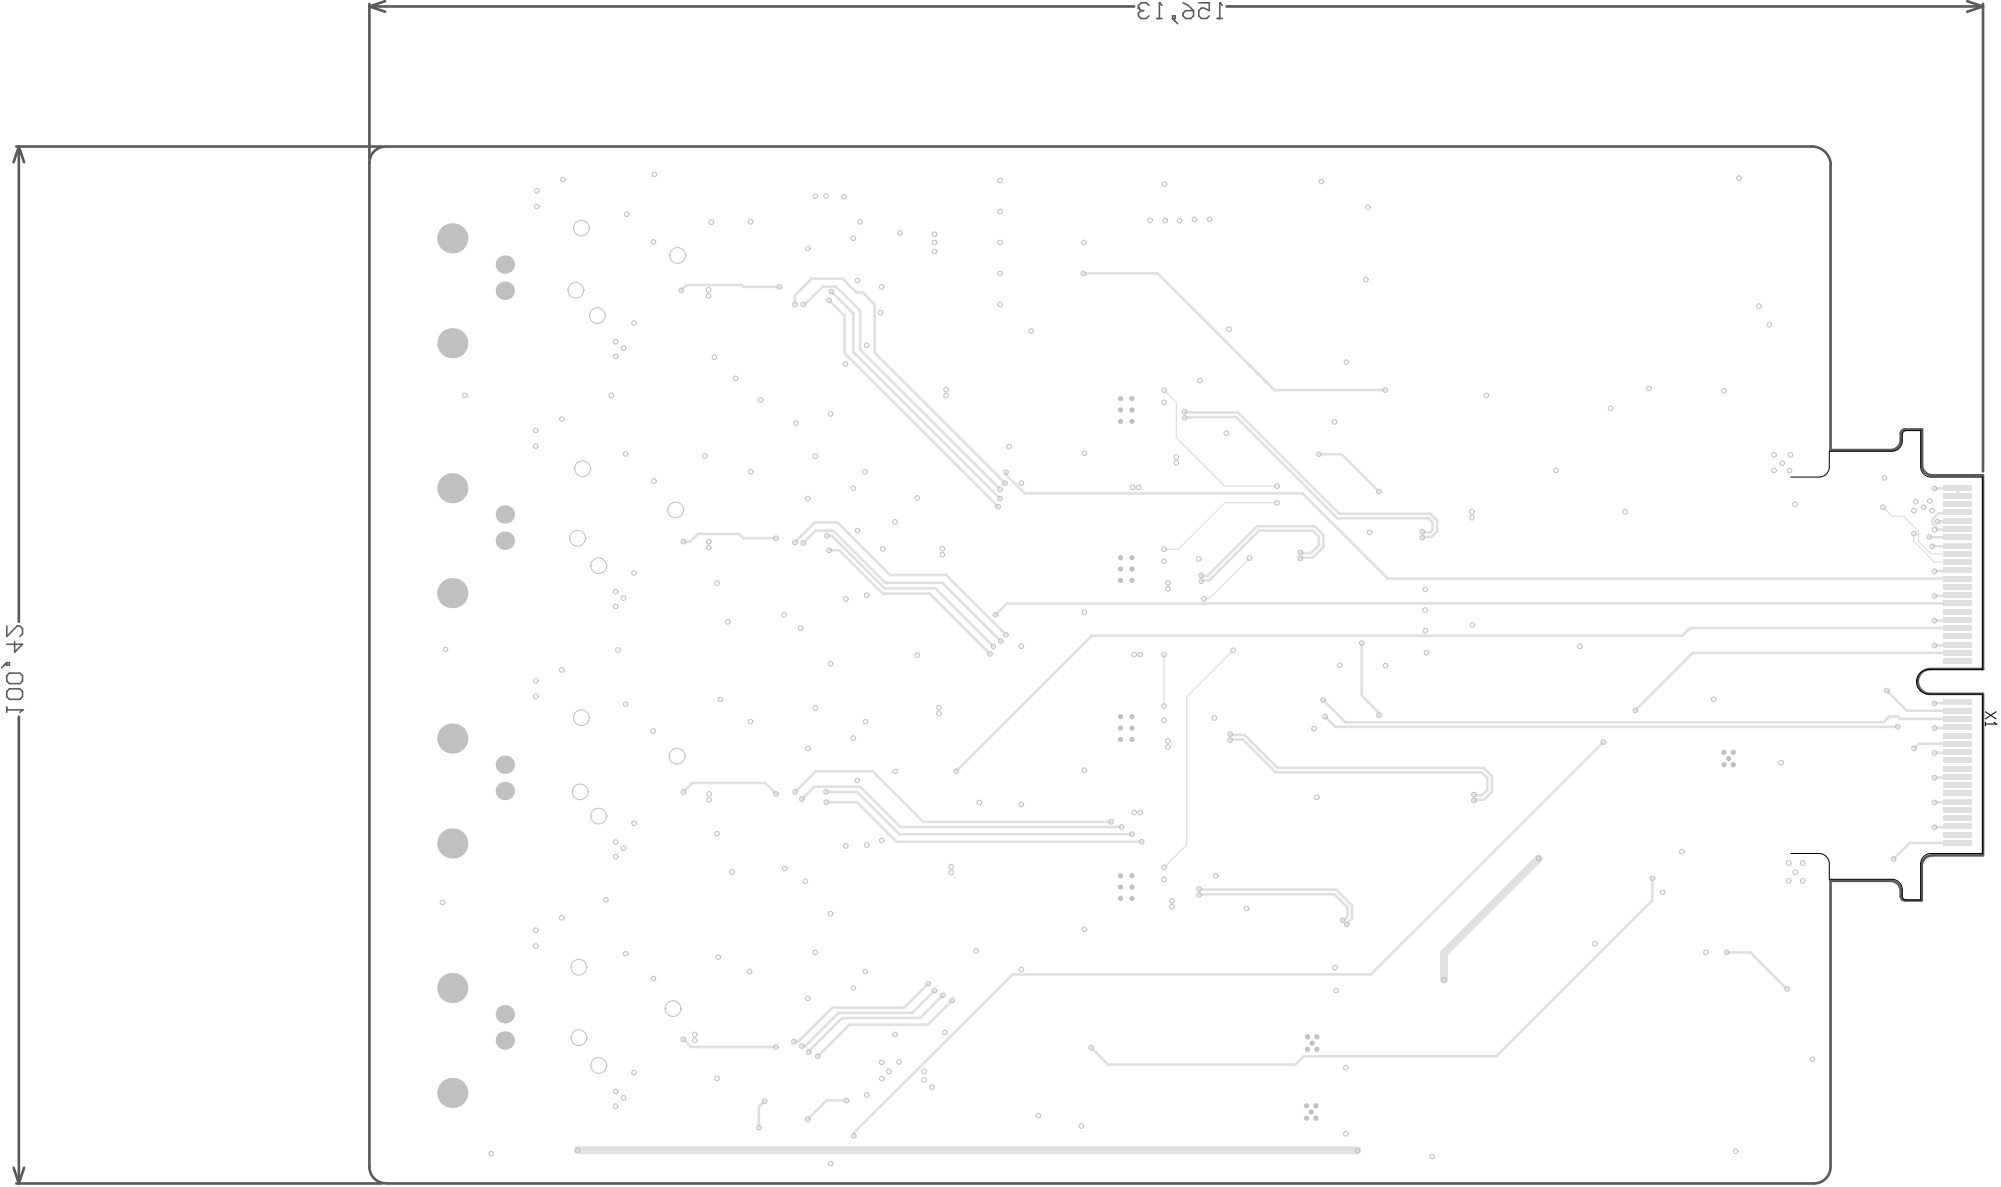
[picture p22: page 2]
