ultrazohm/uz_a_iepe/(list of files, drawings)

Other design files:
ADC.SchDoc
ADC_Ref.SchDoc
CarrierConnector.SchDoc
I2C.SchDoc
IEPE.SchDoc
OpAmp.SchDoc
Power_1.SchDoc
Power_2.SchDoc
Power_3.SchDoc
Power_DCDC.SchDoc
Power_Neg.SchDoc
Power_Pos.SchDoc
TopSheet.SchDoc
uz_d_iepe.PrjPCB
