ultrazohm/uz_a_iepe/(commit log)

2020-02-18 first commit empty project with connectors present
    [ADC.SchDoc, AnalogConnector.SchDoc, BOM_UltraZohm_ADC_2v03.xls, BOM_UltraZohm_ADC_Buffer_2v03.xls, BOM_UltraZohm_ADC_Buffer_2v03.xlsx, CarrierConnector.SchDoc, OpAmp.SchDoc, Power.SchDoc]
2020-02-18 removed sheets that do not belong to template
    [ADC.SchDoc, AnalogConnector.SchDoc, BOM_UltraZohm_ADC_2v03.xls, BOM_UltraZohm_ADC_Buffer_2v03.xls, BOM_UltraZohm_ADC_Buffer_2v03.xlsx, CarrierConnector.SchDoc, OpAmp.SchDoc, Power.SchDoc]
2021-05-17 raw Schedules added, TopSheet drafted
    [ADC.SchDoc, ADC_Ref.SchDoc, AnalogConnector.SchDoc, CarrierConnector.SchDoc, IEPE.SchDoc, OpAmp.SchDoc, Power_Neg.SchDoc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]
2021-05-20 Schematicts edited, no new parts
    [ADC.SchDoc, ADC_Ref.SchDoc, CarrierConnector.SchDoc, IEPE.SchDoc, OpAmp.SchDoc, Power_Neg.SchDoc, TopSheet.SchDoc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]
2021-05-25 some progress, splitet OPA-Sheet, new I2C-Sheet
    [ADC.SchDoc, ADC_Ref.SchDoc, CarrierConnector.SchDoc, I2C.SchDoc, IEPE.SchDoc, OpAmp.SchDoc, Power_Neg.SchDoc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]
2021-05-27 new Lib Parts added
    [I2C.SchDoc, IEPE.SchDoc, OpAmp.SchDoc, TopSheet.SchDoc, UltraZohm_ADC.PrjPCB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]
2021-06-10 IEPE-Tiefpassfilter (OPAMP ersetzen)
    [IEPE.SchDoc]
2021-06-10 IEPE.SchDoc Annoted
    [IEPE.SchDoc]
2021-06-10 added Powertree, conected I2C
    [ADC_Ref.SchDoc, CarrierConnector.SchDoc, I2C.SchDoc, IEPE.SchDoc, OpAmp.SchDoc, Power_DCDC.SchDoc, Power_Neg.SchDoc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]
2021-10-08 Layout of the IEPE PCB and updating of the schematics
    [ADC.SchDoc, ADC_Ref.SchDoc, CarrierConnector.SchDoc, I2C.SchDoc, IEPE.SchDoc, OpAmp.SchDoc, Power_1.SchDoc, Power_2.SchDoc]
2021-10-11 Last commit before renaming the project
    [ADC.SchDoc, CarrierConnector.SchDoc, OpAmp.SchDoc, Power_2.SchDoc, TopSheet.SchDoc]
2021-10-12 Ready for review
    [ADC.SchDoc, I2C.SchDoc, Power_2.SchDoc, UltraZohm_ADC.PrjPCB, UltraZohm_ADC.SCHLIB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]
2021-12-02 Output files generated and added to the files
    [BOM_uz_d_iepe_1v01.xls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]
2024-12-10 fix project reference to pcbdoc file, warning: PCB outline is wrong, origin is wrong!
    [uz_d_iepe.PrjPCB]
